SDNT8810/Timiac/Simulator/close.jpeg

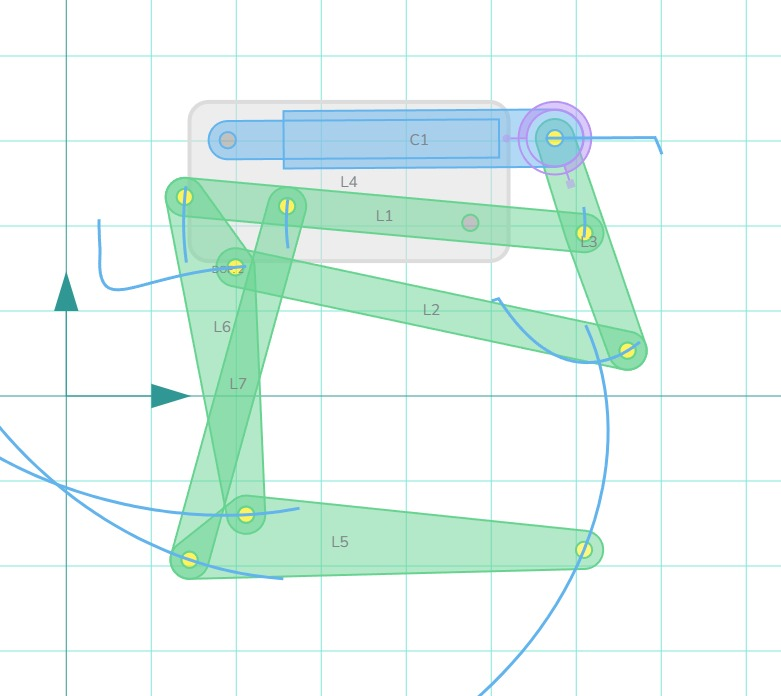
Simulator/close.jpeg
