SDNT8810/Timiac/Docs/remote-updates.md

# Remote updates for all five boards — 2026-10-15.6

**Local hotspot updates are also supported from 2026-10-19.2.** Cloud and USB
remain available. See [local hotspot, cloud and USB instructions](local-updates.md).

After one initial installation, update the master ESP32, both ESP-12 bridges,
and both Octopus boards through **https://control.timiac.it/**. Only the master
needs internet; it forwards the other images over the clock's own Wi-Fi.
No PC beside the clock or extra control wires are needed for routine updates.

This package changes the homing configuration and identity to
**TIMIAC2-f09aa035bf26**. Install all five boards locally with this matched package;
the OTA service deliberately rejects changes to the hardware identity.

## Initial installation in Italy — once

Follow [instruction.md](../instruction.md) using this complete package:

1. Turn the system off. Update both Octopus cards with
   `python run.py octopus_release --sd I:\` (use each card's actual drive).
   Boot each board, confirm `firmware.bin` became `FIRMWARE.CUR`, then turn it off.
   **Reinsert the cards and leave them installed.** Use writable FAT32 cards.
2. Flash each ESP-12 separately through its 3.3 V programming adapter:
   `python run.py esp1_release --port COM5`, then
   `python run.py esp2_release --port COM5` (use the actual COM ports).
3. Flash the master with `python run.py master_release --port COM10`.
4. Reconnect the usual UART/power wires. Start the complete clock and connect
   the master to its internet router. Check both boards, the RTC and hand input.
5. Sign in at **https://control.timiac.it/**. Firmware updates should report ready.
   Perform the first remote update while someone is still beside the clock,
   and confirm Calibrate arms (under Maintenance), Open, and Start clock work afterward.

The existing ESP and Octopus bootloaders are used. Initial ESP flashing includes
the normal ESP bootloader/layout; the new application enables its update receiver.
The Octopus factory 32 KB SD bootloader is preserved. It installs a verified image
from the card after an automatic reset. Do not replace the Octopus bootloader or
change its BOOT jumper for this procedure.
An older Octopus application must receive the initial SD update before remote
updates can work; a bootloader change alone does not add this receiver.

## Routine update from Canada

On your PC, pull a complete, verified firmware package and run:

```powershell
git pull
python remote_update.py --target all
```

Enter the same **Andrea** dashboard password when prompted. The command checks
the local package, signs in over HTTPS, updates the master application, both
bridges, both Octopus boards, then the local dashboard, and waits for each result.
It stops on an error and never automatically retries a failed flashing job.

For one component use `--target esp1`, `esp2`, `octopus1`, `octopus2`, or `master`.
`master` includes its matching dashboard; `dashboard` updates that filesystem alone.
No Cloudflare token or account credentials are needed to perform a normal update.

On the remote dashboard, open **Firmware updates > Update one component from
GitHub**, choose a target and press **Update selected component**. No `.bin`
file or PC build is required. The service pins the latest pushed main commit,
reuses its verified GitHub build when available, and uploads/installs only the
selected image. If that exact build is missing or invalid, it compiles first.
Progress survives closing the page. **Full update** remains the option that
installs all six components; it does not automatically skip unchanged boards.

The automatic component mapping is:

| Dashboard target | Prepared GitHub image |
|---|---|
| Master ESP32 — application | `esp_master_release.bin` |
| Master ESP32 — local dashboard | `master_release_littlefs.bin` |
| ESP-12 bridge 1 | `esp_board1.bin` |
| ESP-12 bridge 2 | `esp_board2.bin` |
| Octopus 1 or Octopus 2 | `firmware.bin` (same image for both) |

Wait for **complete** before the next update. Keep power connected. Updates pause
the clock, cancel queued motion, and wait for the connected bridges to acknowledge
Stop. The clock remains parked across an update reboot. When finished, select
**Maintenance > Calibrate arms**, then **Show time / Start clock**. Starting the clock restores the normal
automatic startup behavior for subsequent power cycles.

Keep the mechanism clear and secure any load that relies on motor holding torque:
an Octopus reset temporarily disables its motor outputs.

## Verification and recovery

The cloud accepts only authenticated administrator uploads and checks file size,
board role, revision and image headers. Files are immutable and SHA-256 identified.
Downloads require the clock's device key over verified HTTPS. Bridge updates use
a per-boot challenge and HMAC-SHA256 covering the target, size, hash and job metadata.
Authorization headers carry an HMAC rather than a plaintext key. Paired firmware
images contain the existing shared device key; the local transfer uses the clock's
WPA2 Wi-Fi. This is not an independent public-key firmware-signing system.

Both the master and receiving bridge check SHA-256 before activation. Octopus
images are first staged on their bridge, then transferred in numbered, CRC-checked
blocks to `timiac.upd` on the microSD. Marlin checks the entire file and its SD
readback before renaming it to `firmware.bin` and resetting into the factory loader.
An incomplete upload stays under a non-boot filename. Command retries do not write
the same block twice. A later attempt first clears any abandoned staging session.

Only one update or motion command may be queued. Update requests expire if not
started promptly and belong to one master boot session. A delivered job is not
replayed after a disconnect. **Stop** cancels transfer/staging before activation;
once flash activation or the bootloader copy has started, let it finish.

Routine OTA preserves the partition table, bootloaders and saved router settings.
The master filesystem is a separate update; stopping it or losing power can damage those
local web files, but the cloud updater can replace them again if the app still runs.
ESP32 application slots retain the previous image during download. The stock ESP
bootloaders do not provide a tested automatic health rollback for a bad application.
USB/SD recovery can still be required after power loss during flash copying or if
an installed application fails to boot or connect to Wi-Fi. A Marlin fatal halt
still requires resetting that Octopus before it can process an update.

This update supports firmware for the existing machine identity and flash layout.
A package that changes the mechanical/hardware identity is rejected; install such
a matched hardware migration locally. Firmware bootloaders themselves are not
replaced remotely.

Bridge maintenance addresses are `192.168.4.241:3232` and `192.168.4.242:3232`,
outside the normal AP DHCP lease range. They have no direct internet service.
The existing tracked clock pairing key is also used for update authentication;
repository access therefore includes access to that pairing material.

All boards compile and automated transfer/authentication/failure tests are run.
An end-to-end update on the physical clock has not been performed here.

## Gateway maintenance

For this initial cloud deployment, apply the additional tables before publishing:

```powershell
cd CloudGateway
npx wrangler d1 execute timiac-control --remote --file cloudflare/schema.sql
npm run check
npm test
npm run deploy
```

Firmware is stored in 64 KiB chunks in the existing D1 database; no new cloud
service or billing account is required. The existing login protects upload and
installation endpoints. Unused artifacts and finished receipts older than a week
are pruned on upload. See [CloudGateway/README.md](../CloudGateway/README.md).

References: [ESP32 OTA partitions](https://docs.espressif.com/projects/esp-idf/en/stable/esp32/api-reference/system/ota.html),
[ESP8266 updater](https://arduino-esp8266.readthedocs.io/en/3.1.1/ota_updates/readme.html),
[BTT Octopus SD bootloader](https://github.com/bigtreetech/docs/blob/master/docs/Octopus.md),
[Cloudflare D1 limits](https://developers.cloudflare.com/d1/platform/limits/).

## Full update: one button

Open the remote dashboard, sign in, and press **Full update** under Firmware updates. No firmware files need to be selected.

1. The server identifies the latest pushed commit on main and requests its verified firmware bundle.
2. GitHub prepares the bundle automatically after each push. Full update reuses the bundle for that exact commit when available; otherwise it builds it. Every component is checked before any board is updated.
3. The server installs the complete package in sequence, waiting for each board's verified success and reboot before continuing. Progress survives closing the browser.
4. If any build or installation fails, the sequence stops. Check the message/build log before trying again. Keep power connected throughout installation. **Stop** cancels the remaining sequence; a flash already activating must finish safely.
5. After success, calibrate/home the arms and resume operation from the dashboard.

Timiac installs the master ESP32 application first, then ESP bridge 1, ESP bridge 2,
Octopus 1, Octopus 2 and finally the local dashboard (six steps across five boards).
The displayed step number identifies the current step, not how many components
have succeeded. A failure at step 4 (Octopus 1) leaves steps 5 and 6 unattempted.
The master receives updater fixes before forwarding the other images. See
[USB recovery and persistent diagnostic logs](ota-recovery.md) if the old master
is offline or cannot finish its own update.

For one component, use **Update one component from GitHub** instead. That
request uploads one image and creates a single `1/1` installation step. Selecting
the master application updates only that application; select **Master ESP32 —
local dashboard** separately if its web files also changed. Bridges and Octopus
boards are not flashed as part of a master-only selection. All six supported
target/image pairs remain available.

From 2026-10-20.2, bridges persist the exact Octopus activation receipt before
requesting a reboot. A bridge restart during confirmation resumes checking the
running Octopus revision without requesting activation again. The master checks
the full receipt and the reported running revision before advancing. See
[Octopus SD update failures](sd-update-timeout.md) for the October 20 diagnosis.

### Faster build preparation — 2026-10-20

Pushing main starts a build-only preparation job; it does not contact, Stop or
update the clock. The prepared bundle is cached by the full source commit SHA.
Pressing Full update still resolves the current main commit and verifies every
image's SHA-256, role, revision and hardware identity before uploading it.
There is no fallback to firmware from a different commit. A missing, evicted or
invalid cache triggers a fresh build. Upload and sequential board installation
still take time even when compilation is skipped.

Builds for one commit queue together so an update can reuse an in-progress
preparation job. The workflow also caches pip/PlatformIO downloads, checks out
only shallow source history, and uses `python build.py cloud` to build the
release master, both ESP bridges and Octopus without the unused development
master. The complete verified bundle is saved before upload, so an interrupted
upload can reuse it on the next attempt. Cache eviction or the first run of a
new commit still needs compilation; no fixed completion time is guaranteed.

For local build verification without replacing the shipped binaries:

```powershell
python build.py cloud --output-dir .local/cloud-build-validation
```

The normal `python build.py all` and individual dev/release targets remain
available. This workflow change applies to new runs; an already-running Full
update keeps the workflow with which it started.

The initial USB/SD setup is still required once. Leave all Octopus microSD cards inserted and connect the controller to Internet Wi-Fi. Push your code before using Full update: uncommitted changes on a PC are not included.

### Automatic-build setup (maintainers)

The gateway uses `GITHUB_REPOSITORY`, `GITHUB_REF`, and the Worker secrets `GITHUB_BUILD_TOKEN` (repository Actions write/content read) and `FIRMWARE_BUILD_KEY`. The matching repository Actions secret `FIRMWARE_BUILD_KEY` authenticates uploads only; browser accounts and device keys cannot publish builds. `.github/workflows/full-update.yml` must also exist on the repository default branch for workflow dispatch registration. Lumiac's source/build branch remains RF.

Before deploying single-component selection to an existing Timiac gateway,
apply `CloudGateway/cloudflare/component-update.sql` once. It adds the durable
selection columns without changing existing update records. Push the workflow
and publisher first; single-component dispatches use the new optional
`component_target` and `component_kind` inputs.

The workflow runs on GitHub-hosted runners; no local PC or VPS build agent is needed. Build failures are reported to the dashboard. GitHub Actions must be enabled and have available build minutes. The builder uploads the verified complete bundle; bootloaders and partition tables are excluded from OTA.

For a build-only smoke test, an authenticated administrator can POST `{"validateOnly":true}` to `/api/devices/DEVICE_ID/full-update`. This builds and verifies everything without creating hardware update jobs. Normal dashboard clicks always build and install.

### Using another PC

The firmware's paired cloud configuration is committed with the source. `CloudGateway/project-secrets.json` also contains the project device key, Firebase API key, and full-build upload key, as requested. A normal pull includes these files; no credential copy/paste is needed to flash firmware or use the existing Full update service.

To reapply the project secrets to the existing Cloudflare Worker after signing into Wrangler, run `npm run configure:secrets --prefix CloudGateway`. This preserves its separately configured GitHub build account token. Repository/account authorization itself uses your normal GitHub and Cloudflare sign-in.
