SDNT8810/Timiac/Simulator/clock.jpeg

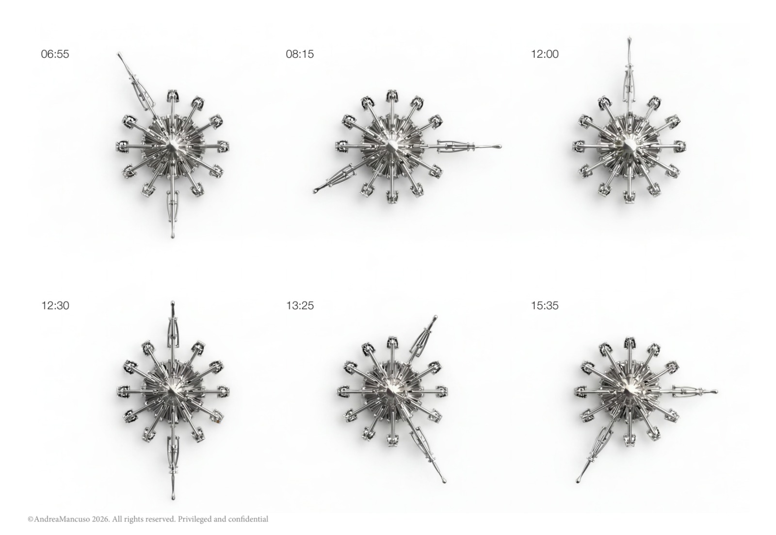
Simulator/clock.jpeg
