SDNT8810/Timiac/Simulator/mechanism.jpeg

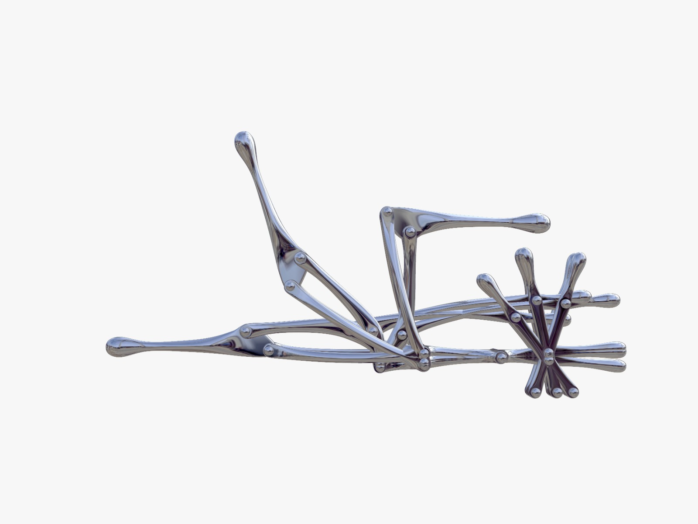
Simulator/mechanism.jpeg
