SDNT8810/Timiac/Simulator/open.jpeg

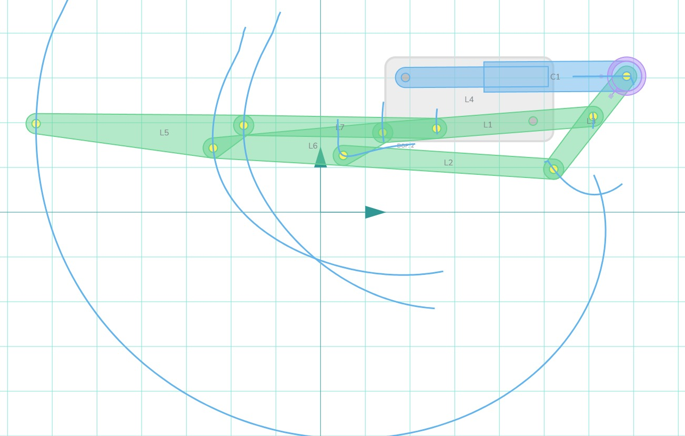
Simulator/open.jpeg
