SDNT8810/Timiac/Docs/wiring.md

# Twelve-motor wiring and commissioning

## Master ESP32-WROOM-32: RTC and new infrared hand sensor

Use the [complete master-board diagram and instructions](master-wiring.md):

Master ESP32 wiring

Keep the current **24 V to 3.3 V converter**, ESP32 and DS3231 connections.
For firmware **2026-10-20.3**, move only the installed low-voltage signal wire
from **GPIO27 to GPIO34 (ADC1)**. Keep the sensor power, common ground and all
installed resistors unchanged. The reported input is 95 mV clear and 2.5 mV
with a hand. The firmware uses analog presence detection rather than a digital
HIGH/LOW read. See the [sensor diagram](master-sensor-wiring.svg) and the
[low-voltage ADC limitations](master-wiring.md#analog-detection).
Never connect a raw 24 V sensor output directly to the ESP32. Keep the old
ultrasonic module unplugged and its GPIO18/19 traces unused.

| Module / signal | Master ESP32 connection |
|---|---|
| Converter 3.3 V output | 3V3 and DS3231 VCC |
| Converter / PSU / sensor ground | GND and DS3231 GND |
| DS3231 SDA | GPIO21 |
| DS3231 SCL | GPIO22 |
| Installed sensor resistor-divider junction | GPIO34, ADC1 analog input (no pull-up) |
| Existing ultrasonic GPIO18/19 | Unused |

These are GPIO labels, not development-board header positions. Leave RTC SQW
and 32K unconnected. The DS3231 and its I²C pull-ups remain at 3.3 V. The master
communicates with the motor bridges over Wi-Fi; it has no Octopus UART wiring.

Check both states' actual ADC readings as shown in [master-wiring.md](master-wiring.md). The dashboard reports
**Detected / Clear**, not centimetres. Clear for 500 ms, then present a hand for
200 ms to trigger one of seven random Struggle patterns once (valid RTC required).
Motion, Stop and faults discard hand
arrivals. A held hand cannot repeat until withdrawn. Manual release Home keeps
the arms parked; gestures require Start clock in release mode.

RTC diagnostics remain available at **http://192.168.4.1/api/rtc**. The bus uses
100 kHz, SDA GPIO21 and SCL GPIO22. `stage: address_probe` with `i2cCode: 2`
means address 0x68 did not acknowledge; code 5 means a timeout. A lost-power
message after successful communication requires setting the date/time.
See the [DS3231 manufacturer datasheet](https://www.analog.com/media/en/technical-documentation/data-sheets/ds3231.pdf).

## Per-axis commissioning baseline

Both boards use the identical six-axis image, adapted from Lumiac's working
configuration for TMC2209 UART and Timiac's mechanics. See
[lumiac-comparison.md](lumiac-comparison.md); confirm direction and calibration
on each physical mechanism before production use.

| Setting | Value |
|---|---|
| Board / MCU | BIGTREETECH Octopus V1.1 / STM32F446ZET6 |
| Motor / driver | X/Y/Z/A/B/C in G-code; Marlin internally calls the last three drivers I/J/K |
| Planned supply / chopper timing | 24 V / 400 W (16.7 A), CHOPPER_DEFAULT_24V |
| Current / microsteps | 1,000 mA RMS requested / 64 commanded, interpolated to 256 |
| Steps / travel | 11,520 steps/mm / 0–50 mm |
| Maximum feed | 8.333 mm/s = 500 mm/min |
| Acceleration | S-curve: 25 mm/s² travel, 80 mm/s² per-axis ceiling |
| Homing speed / direction | 120 mm/min, concurrent physical microswitch homing / toward each axis minimum |
| Stepper inactivity timeout | 600 seconds |
| Home input | Per-axis input in the table below, pull-up, normally closed switch to GND |
| Endstop inversion | false: released LOW, triggered HIGH |
| UART / USB | USART3 and USB, 115200 baud |
| Runtime SD / EEPROM settings | disabled |

The home endstop is at the **fully open** arm position: actuator **0 mm**.
Moving toward **50 mm closes** the arm. Keep the working motor directions and
minimum-endstop wiring; the master reverses visual clock/animation targets.
Both bridges and Octopus boards execute native actuator coordinates directly.

The active twelve-motor profile uses the reported actuator measurement on all
arms: 40 mm commanded produced 50 mm from home, so steps/mm becomes
`900 × 40 / 50 = 720` at four microsteps. At the selected 64 commanded microsteps,
the equivalent calibration is `720 × 64 / 4 = 11,520` steps/mm.
The driver interpolates internally to 256 microsteps. The 500 mm/min maximum
requires 96,000 step pulses/s; homing retains its 120 mm/min feed.
Home all uses Lumiac's independent per-motor switch stopping on both boards. Sensorless homing is removed in both modes.
Remove any MOTOR0–5 DIAG jumpers and reconnect NC switches with power off.
The generated image identifies itself
with the `TIMIAC2-` machine hash shared by all ESP images.

Flash the new `firmware.bin` to both Octopus boards, plus the updated master
and both bridge ESP images for the longer homing budgets. Home first, then
check a 10 mm move before rechecking 40 mm of actuator travel from zero.
These calculated settings still need a physical measurement after flashing.

M119 must show open when the switch is released and TRIGGERED when
actuated. Disconnecting an NC switch should also report TRIGGERED.
Verify each of the twelve switch inputs with stationary motors before running G28.
Install the driver's UART jumper; remove the DIAG jumper for a physical sensor.

### A/B/C homing troubleshooting

The latest profile restores `INVERT_I_DIR`, `INVERT_J_DIR`, and `INVERT_K_DIR`
to `false`, undoing the preceding direction reversal. This is a rollback,
not confirmation of the actual motor wiring or physical home direction.

The wiring counts the first endstop input as 1: X/Y/Z/A/B/C use the first six
inputs. A uses the 4th input (PG11 / STOP3), B the 5th (PG12 / STOP4), and
C the 6th (PG13 / STOP5). The previous PG12/PG13/PG14 mapping was one input
too high for this wiring. The current Lumiac layout uses MOTOR3/MOTOR4/MOTOR5 for A/B/C;
the motor output number does not select the endstop input.

For these physical switches, remove any DIAG3/DIAG4/DIAG5 jumpers connecting
driver diagnostic outputs to the three selected endstop inputs. Switch off
board power before changing jumpers. Keep the driver UART jumpers installed.

With all motors stationary, run M119 with each switch released and pressed.
Only the corresponding `a_min`, `b_min`, or `c_min` line should
change from `open` to `TRIGGERED`. If it does not change, check the connector,
signal/GND wiring, switch contact and DIAG jumper before attempting motion.

`echo:Bad A Endstop?` specifically means Marlin still reads the A home input
as triggered after the 5 mm homing backoff. The message confirms it recognized
axis A. This can happen if the switch is held, another arm's switch is connected
to the A input, the circuit is open, the driver/motor does not back off, or the
mechanism has not released the switch. The message alone does not distinguish
those causes. On Board 1 the A1 input is STOP3 / PG11 and its motor is now MOTOR3.

This error calls Marlin's `kill()` and requires the affected Octopus RESET
button or a power cycle. After reset, use the development switch lamps with
stationary motors: A1 should be red when released and green when pressed, and
only A1 should change. Do not hold the switch during an automatic homing
backoff. An NC switch or wire left disconnected reads triggered too.
The corrected bridge preserves this cause and shows **Reset required**;
Stop acknowledgements and later UART timeouts cannot erase it. Homing and
switch wiring still need physical verification after the fault is corrected.

Marlin's initial homing search is 1.5 times the configured 50 mm travel
(75 mm commanded). Do not wait for that search to finish if the motor moves
away from its sensor. `VALIDATE_HOMING_ENDSTOPS` stops on a missed switch;
`DETECT_BROKEN_ENDSTOP` now also stops if a switch remains triggered after
the 5 mm backoff. Neither check can establish that the physical direction
or wiring is correct.

## ESP32 master and two ESP-12S bridges

The master connects to power, the RTC and the hand sensor as shown above;
do not wire it to either Octopus serial port.
Each bridge connects only to its own Octopus:

| Bridge signal | Octopus signal |
|---|---|
| GPIO1 / TXD0 | PD9 / USART3 RX |
| GPIO3 / RXD0 | PD8 / USART3 TX |
| GND | GND |
| VCC | regulated 3.3 V |

Signal levels are 3.3 V. Do not put 5/12/24 V on an ESP or MCU signal pin.
A bare ESP needs adequate supply decoupling and Wi-Fi burst current,
EN/reset high, GPIO0/GPIO2 high, and GPIO15 low for normal boot.
Check the ESP-12S module's built-in resistors and actual Octopus socket
orientation. The pin table identifies electrical signals, not breakout dimensions.

All ESP builds assume 4 MB flash. Use UART at 115200, 8N1.
Remote firmware updates use the same wires, plus a FAT32 microSD card left in
each Octopus. See [the initial setup and remote update guide](remote-updates.md).
Do not connect two TX outputs together. Disconnect the Octopus UART when
flashing a bridge with a USB-UART adapter. Pull GPIO0 low during reset to
enter flashing mode, then release it for normal operation.

An optional physically rewired setup can set TIMIAC_SERIAL_SWAP = 1:
GPIO15/TX → PD9 and GPIO13/RX ← PD8. GPIO15 must remain low during reset.
This avoids ROM boot messages on the bridge's control TX but does not match
the default UART0 socket wiring.

## Flashing order

1. Use the same firmware/two-motor/firmware.bin on both FAT32 microSD cards.
   Boot each Octopus and confirm FIRMWARE.CUR. Bootloader SD flashing still
   works although runtime SD support and auto0.g execution are disabled.
   After confirming the flash, power off, remove the card, and power on again.
2. Flash timiac_master and its filesystem; flash timiac_board1 and
   timiac_board2 onto their respective bridges. Instructions are in [README](../README.md).
3. Connect the UART links and power all boards. Join Timiac / 12345678.
4. Open http://192.168.4.1, Take control, and inspect M115/M122/M119 logs.
   Both boards must report AXIS_COUNT:6 and answer normal Marlin status queries.
5. Home each local X/Y/Z/A/B/C axis separately, then test a 1 mm move on each motor.
6. Under supervision, verify Stop and interrupted-link behavior before larger
   programs. Stop uses M410 for ordinary movement and M112 during homing;
   interrupted homing requires an Octopus reset. Keep loads supported and
   a physical motor-power cutoff available.

After an ordinary Stop, wait for both bridges to reconnect, then Home again.
A board showing `Printer halted. kill() called!` needs its reset button or a
power cycle. Do not send USB motion or settings commands while
using the network controller.

## Active axis mapping

| Master Board 1 | Master Board 2 | Local Marlin | Motor socket | Endstop counted from 1 | Home input |
|---|---|---|---|---|---|
| X1 | X2 | X | MOTOR0 | 1st | STOP0 / X-STOP / PG6 |
| Y1 | Y2 | Y | MOTOR1 | 2nd | STOP1 / Y-STOP / PG9 |
| Z1 | Z2 | Z | MOTOR2_1 / DRIVER2 | 3rd | STOP2 / Z-STOP / PG10 |
| A1 | A2 | A | MOTOR3 / DRIVER3 | 4th | STOP3 / Z2-STOP / PG11 |
| B1 | B2 | B | MOTOR4 / DRIVER4 | 5th | STOP4 / E0-DET / PG12 |
| C1 | C2 | C | MOTOR5 / DRIVER5 | 6th | STOP5 / E1-DET / PG13 |

The active mapping now matches Lumiac: DRIVER0 through DRIVER5. Z uses the
MOTOR2 channel; MOTOR2_1 and MOTOR2_2 are parallel outputs of the same driver.
Use MOTOR2_1 for the single Z actuator and leave MOTOR2_2 empty. MOTOR6/7 are
unused. UART pins are PC4, PD11, PC6, PC7, PF2 and PE4 in X/Y/Z/A/B/C order.

To change from the preceding bypass layout, disconnect all board power and USB,
then move each driver and motor cable: Z 3→2, A 4→3, B 5→4, C 6→5. X/Y remain
on MOTOR0/1. The home switches do not move. Fit TMC2209 UART jumpers at all six
occupied slots; Lumiac uses a different SPI jumper arrangement. The user is
replacing both boards with new boards, so the old damaged channels no longer
determine this layout. Counting from DRIVER0, the third driver slot is DRIVER2
and serves both MOTOR2 connectors; the fourth slot is DRIVER3 and serves MOTOR3.

Pin references are in the vendored
Marlin/src/pins/stm32f4/pins_BTT_OCTOPUS_V1_common.h.
ESP serial behavior is documented in the
[ESP8266 core reference](https://arduino-esp8266.readthedocs.io/en/3.1.2/reference.html#serial).
