SDNT8810/Timiac/Docs/master-sensor-wiring.png

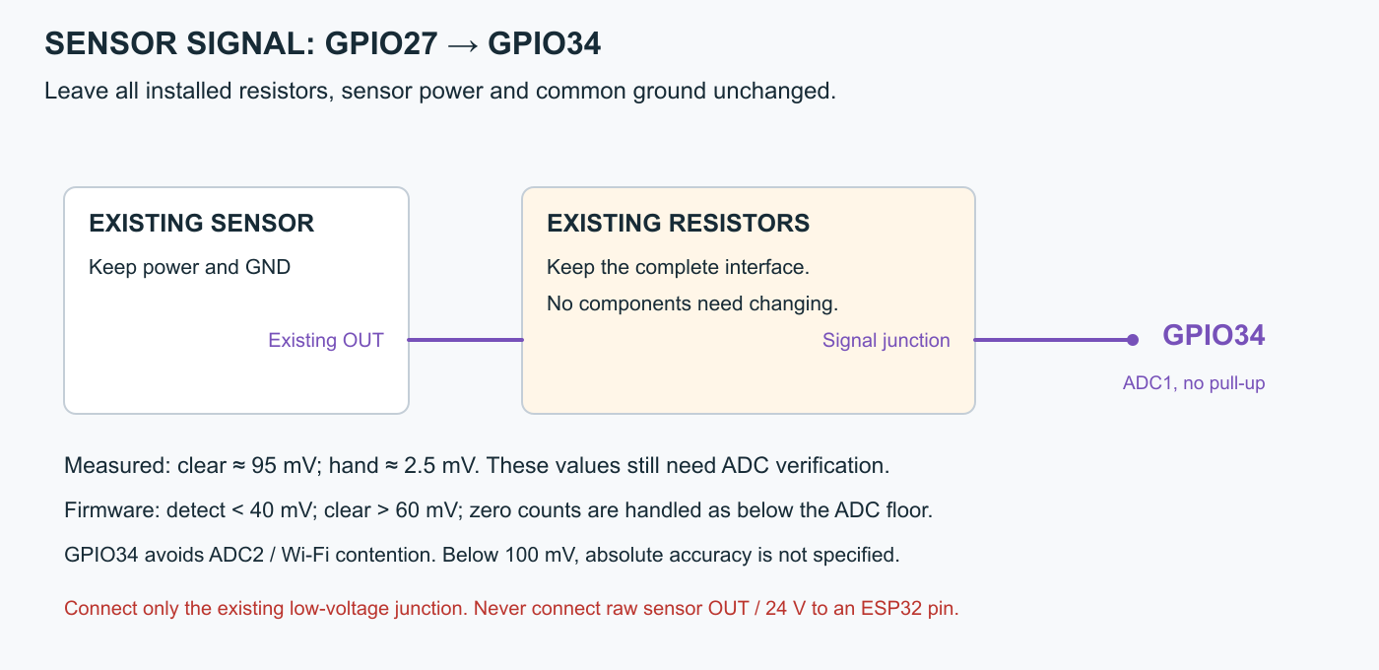
Docs/master-sensor-wiring.png
