SDNT8810/Timiac/Docs/master-wiring.png

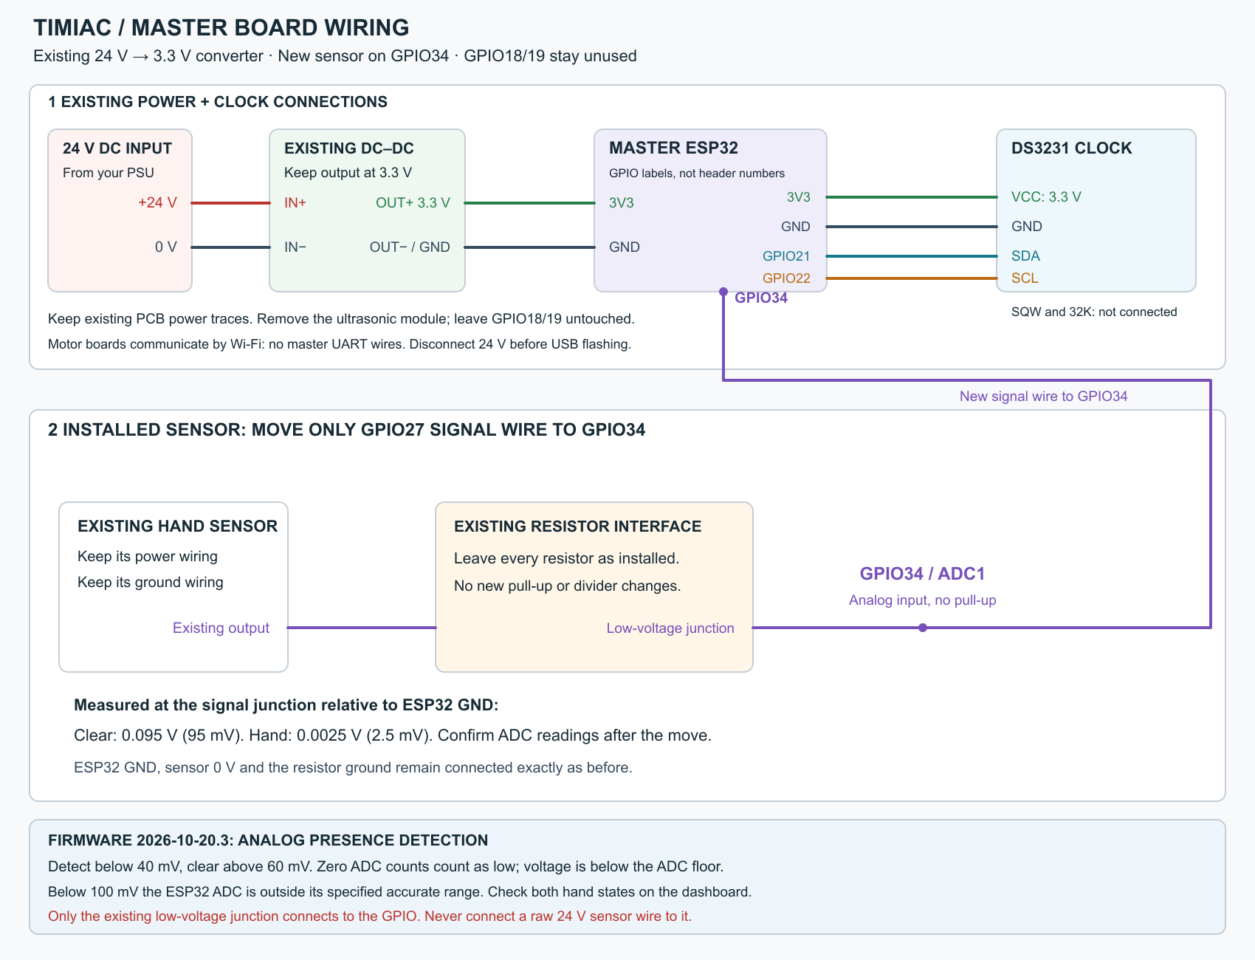
Docs/master-wiring.png
