SDNT8810/Timiac/Marlin/profiles/lumiac-reference/Configuration.h

#pragma once
#define CONFIG_EXAMPLES_DIR "linear_axes/Octopus 8 LINEAR_AXES"
#define CONFIGURATION_H_VERSION 02010206
#define STRING_CONFIG_H_AUTHOR "(OpenAI, Octopus v1.1 6-axis spider)" // Who made the changes.
#define SHOW_BOOTSCREEN
  #define MOTHERBOARD BOARD_BTT_OCTOPUS_V1_1
#define I_STEP_PIN    PG4   // MOTOR 3
#define I_DIR_PIN     PC1
#define I_ENABLE_PIN  PA0
#define I_CS_PIN      PC7
#define J_STEP_PIN    PF9   // MOTOR 4
#define J_DIR_PIN     PF10
#define J_ENABLE_PIN  PG2
#define J_CS_PIN      PF2
#define K_STEP_PIN    PC13  // MOTOR 5
#define K_DIR_PIN     PF0
#define K_ENABLE_PIN  PF1
#define K_CS_PIN      PE4
#define I_MIN_PIN     PG11  // Z2-STOP
#define J_MIN_PIN     PG12  // E0DET
#define K_MIN_PIN     PG13  // E1DET
#define U_MIN_PIN     PG14  // E2DET
#define V_MIN_PIN     PG15  // E3DET
#define SERIAL_PORT -1
#define BAUDRATE 250000
#define SERIAL_PORT_2 3
#define BAUDRATE_2 115200   // ESP bridge on Octopus WIFI header (PD8/PD9)
#define CUSTOM_MACHINE_NAME "Hexapod Spider"
#define X_DRIVER_TYPE  TMC5160
#define Y_DRIVER_TYPE  TMC5160
#define Z_DRIVER_TYPE  TMC5160
#define I_DRIVER_TYPE  TMC5160
#define J_DRIVER_TYPE  TMC5160
#define K_DRIVER_TYPE  TMC5160
  #define AXIS4_NAME 'A' // :['A', 'B', 'C', 'U', 'V', 'W']
  #define AXIS4_ROTATES
  #define AXIS5_NAME 'B' // :['B', 'C', 'U', 'V', 'W']
  #define AXIS5_ROTATES
  #define AXIS6_NAME 'C' // :['C', 'U', 'V', 'W']
  #define AXIS6_ROTATES
#define EXTRUDERS 0
#define DEFAULT_NOMINAL_FILAMENT_DIA 1.75
#define TEMP_SENSOR_0 0
#define TEMP_SENSOR_1 0
#define TEMP_SENSOR_2 0
#define TEMP_SENSOR_3 0
#define TEMP_SENSOR_4 0
#define TEMP_SENSOR_5 0
#define TEMP_SENSOR_6 0
#define TEMP_SENSOR_7 0
#define TEMP_SENSOR_BED 0
#define TEMP_SENSOR_PROBE 0
#define TEMP_SENSOR_CHAMBER 0
#define TEMP_SENSOR_COOLER 0
#define TEMP_SENSOR_BOARD 0
#define TEMP_SENSOR_REDUNDANT 0
#define DUMMY_THERMISTOR_998_VALUE  25
#define DUMMY_THERMISTOR_999_VALUE 100
#if TEMP_SENSOR_IS_MAX_TC(0)
  #define MAX31865_SENSOR_OHMS_0      100 // (Ω) Typically 100 or 1000 (PT100 or PT1000)
  #define MAX31865_CALIBRATION_OHMS_0 430 // (Ω) Typically 430 for Adafruit PT100; 4300 for Adafruit PT1000
#endif
#if TEMP_SENSOR_IS_MAX_TC(1)
  #define MAX31865_SENSOR_OHMS_1      100
  #define MAX31865_CALIBRATION_OHMS_1 430
#endif
#if TEMP_SENSOR_IS_MAX_TC(2)
  #define MAX31865_SENSOR_OHMS_2      100
  #define MAX31865_CALIBRATION_OHMS_2 430
#endif
#if HAS_E_TEMP_SENSOR
  #define TEMP_RESIDENCY_TIME         10  // (seconds) Time to wait for hotend to "settle" in M109
  #define TEMP_WINDOW                  1  // (°C) Temperature proximity for the "temperature reached" timer
  #define TEMP_HYSTERESIS              3  // (°C) Temperature proximity considered "close enough" to the target
#endif
#if TEMP_SENSOR_BED
  #define TEMP_BED_RESIDENCY_TIME     10  // (seconds) Time to wait for bed to "settle" in M190
  #define TEMP_BED_WINDOW              1  // (°C) Temperature proximity for the "temperature reached" timer
  #define TEMP_BED_HYSTERESIS          3  // (°C) Temperature proximity considered "close enough" to the target
#endif
#if TEMP_SENSOR_CHAMBER
  #define TEMP_CHAMBER_RESIDENCY_TIME 10  // (seconds) Time to wait for chamber to "settle" in M191
  #define TEMP_CHAMBER_WINDOW          1  // (°C) Temperature proximity for the "temperature reached" timer
  #define TEMP_CHAMBER_HYSTERESIS      3  // (°C) Temperature proximity considered "close enough" to the target
#endif
#if TEMP_SENSOR_REDUNDANT
  #define TEMP_SENSOR_REDUNDANT_SOURCE    E1  // The sensor that will provide the redundant reading.
  #define TEMP_SENSOR_REDUNDANT_TARGET    E0  // The sensor that we are providing a redundant reading for.
  #define TEMP_SENSOR_REDUNDANT_MAX_DIFF  10  // (°C) Temperature difference that will trigger a print abort.
#endif
#define HEATER_0_MINTEMP   5
#define HEATER_1_MINTEMP   5
#define HEATER_2_MINTEMP   5
#define HEATER_3_MINTEMP   5
#define HEATER_4_MINTEMP   5
#define HEATER_5_MINTEMP   5
#define HEATER_6_MINTEMP   5
#define HEATER_7_MINTEMP   5
#define BED_MINTEMP        5
#define CHAMBER_MINTEMP    5
#define HEATER_0_MAXTEMP 275
#define HEATER_1_MAXTEMP 275
#define HEATER_2_MAXTEMP 275
#define HEATER_3_MAXTEMP 275
#define HEATER_4_MAXTEMP 275
#define HEATER_5_MAXTEMP 275
#define HEATER_6_MAXTEMP 275
#define HEATER_7_MAXTEMP 275
#define BED_MAXTEMP      150
#define CHAMBER_MAXTEMP  60
#define HOTEND_OVERSHOOT 15   // (°C) Forbid temperatures over MAXTEMP - OVERSHOOT
#define BED_OVERSHOOT    10   // (°C) Forbid temperatures over MAXTEMP - OVERSHOOT
#define COOLER_OVERSHOOT  2   // (°C) Forbid temperatures closer than OVERSHOOT
#define PIDTEMP           // See the PID Tuning Guide at https://reprap.org/wiki/PID_Tuning
#define PID_MAX  255      // Limit hotend current while PID is active (see PID_FUNCTIONAL_RANGE below); 255=full current
#define PID_K1     0.95   // Smoothing factor within any PID loop
    #define DEFAULT_KP  22.20
    #define DEFAULT_KI   1.08
    #define DEFAULT_KD 114.00
#define MAX_BED_POWER 255 // limits duty cycle to bed; 255=full current
#define MAX_CHAMBER_POWER 255 // limits duty cycle to chamber heater; 255=full current
  #define PID_FUNCTIONAL_RANGE 10 // If the temperature difference between the target temperature and the actual temperature
#define PREVENT_COLD_EXTRUSION
#define EXTRUDE_MINTEMP 170
#define PREVENT_LENGTHY_EXTRUDE
#define EXTRUDE_MAXLENGTH 200
#define THERMAL_PROTECTION_HOTENDS // Enable thermal protection for all extruders
#define THERMAL_PROTECTION_BED     // Enable thermal protection for the heated bed
#define THERMAL_PROTECTION_CHAMBER // Enable thermal protection for the heated chamber
#define THERMAL_PROTECTION_COOLER  // Enable thermal protection for the laser cooling
#define USE_XMIN_PLUG
#define USE_YMIN_PLUG
#define USE_ZMIN_PLUG
#define USE_IMIN_PLUG
#define USE_JMIN_PLUG
#define USE_KMIN_PLUG
#define USE_UMIN_PLUG
#define USE_VMIN_PLUG
#define ENDSTOPPULLUPS
#define X_MIN_ENDSTOP_INVERTING true  // Set to true to invert the logic of the endstop.
#define Y_MIN_ENDSTOP_INVERTING true  // Set to true to invert the logic of the endstop.
#define Z_MIN_ENDSTOP_INVERTING true  // Set to true to invert the logic of the endstop.
#define I_MIN_ENDSTOP_INVERTING true  // Set to true to invert the logic of the endstop.
#define J_MIN_ENDSTOP_INVERTING true  // Set to true to invert the logic of the endstop.
#define K_MIN_ENDSTOP_INVERTING true  // Set to true to invert the logic of the endstop.
#define U_MIN_ENDSTOP_INVERTING false // Set to true to invert the logic of the endstop.
#define V_MIN_ENDSTOP_INVERTING false // Set to true to invert the logic of the endstop.
#define W_MIN_ENDSTOP_INVERTING false // Set to true to invert the logic of the endstop.
#define X_MAX_ENDSTOP_INVERTING false // Set to true to invert the logic of the endstop.
#define Y_MAX_ENDSTOP_INVERTING false // Set to true to invert the logic of the endstop.
#define Z_MAX_ENDSTOP_INVERTING false // Set to true to invert the logic of the endstop.
#define I_MAX_ENDSTOP_INVERTING false // Set to true to invert the logic of the endstop.
#define J_MAX_ENDSTOP_INVERTING false // Set to true to invert the logic of the endstop.
#define K_MAX_ENDSTOP_INVERTING false // Set to true to invert the logic of the endstop.
#define U_MAX_ENDSTOP_INVERTING false // Set to true to invert the logic of the endstop.
#define V_MAX_ENDSTOP_INVERTING false // Set to true to invert the logic of the endstop.
#define W_MAX_ENDSTOP_INVERTING false // Set to true to invert the logic of the endstop.
#define Z_MIN_PROBE_ENDSTOP_INVERTING false // Set to true to invert the logic of the probe.
#define ENDSTOP_INTERRUPTS_FEATURE
  #define SPIDER_MICROSTEPS 16
#if SPIDER_MICROSTEPS != 2 && SPIDER_MICROSTEPS != 8 && SPIDER_MICROSTEPS != 16 && SPIDER_MICROSTEPS != 32 && SPIDER_MICROSTEPS != 64
  #error "SPIDER_MICROSTEPS must be 2, 8, 16, 32, or 64."
#endif
#define SPIDER_AXIS_STEPS_PER_UNIT (533.33f * SPIDER_MICROSTEPS / 16.0f)
#define DEFAULT_AXIS_STEPS_PER_UNIT { SPIDER_AXIS_STEPS_PER_UNIT, SPIDER_AXIS_STEPS_PER_UNIT, SPIDER_AXIS_STEPS_PER_UNIT, SPIDER_AXIS_STEPS_PER_UNIT, SPIDER_AXIS_STEPS_PER_UNIT, SPIDER_AXIS_STEPS_PER_UNIT }
#define DEFAULT_MAX_FEEDRATE          { 260, 260, 260, 260, 260, 260 } // 30% faster on all six arms
#define DEFAULT_MAX_ACCELERATION      { 80, 80, 80, 80, 80, 80 }
#define DEFAULT_ACCELERATION          25      // X, Y, Z and E acceleration for printing moves
#define DEFAULT_RETRACT_ACCELERATION  25      // E acceleration for retracts
#define DEFAULT_TRAVEL_ACCELERATION   25      // X, Y, Z acceleration for travel (non printing) moves
#define DEFAULT_EJERK    5.0  // May be used by Linear Advance
  #define JUNCTION_DEVIATION_MM 0.003 // (mm) Distance from real junction edge
  #define JD_HANDLE_SMALL_SEGMENTS    // Use curvature estimation instead of just the junction angle
#define S_CURVE_ACCELERATION
#define Z_MIN_PROBE_USES_Z_MIN_ENDSTOP_PIN
#define NOZZLE_TO_PROBE_OFFSET { 10, 10, 0 }
#define PROBING_MARGIN 10
#define XY_PROBE_FEEDRATE (133*60)
#define Z_PROBE_FEEDRATE_FAST (4*60)
#define Z_PROBE_FEEDRATE_SLOW (Z_PROBE_FEEDRATE_FAST / 2)
#define Z_CLEARANCE_DEPLOY_PROBE   10 // (mm) Z Clearance for Deploy/Stow
#define Z_CLEARANCE_BETWEEN_PROBES  5 // (mm) Z Clearance between probe points
#define Z_CLEARANCE_MULTI_PROBE     5 // (mm) Z Clearance between multiple probes
#define Z_PROBE_LOW_POINT          -2 // (mm) Farthest distance below the trigger-point to go before stopping
#define Z_PROBE_OFFSET_RANGE_MIN -20
#define Z_PROBE_OFFSET_RANGE_MAX 20
#define X_ENABLE_ON 0
#define Y_ENABLE_ON 0
#define Z_ENABLE_ON 0
#define E_ENABLE_ON 0 // For all extruders
#define I_ENABLE_ON 0
#define J_ENABLE_ON 0
#define K_ENABLE_ON 0
#define U_ENABLE_ON 0
#define V_ENABLE_ON 0
#define DISABLE_OTHER_EXTRUDERS   // Keep only the active extruder enabled
#define INVERT_X_DIR false
#define INVERT_Y_DIR false
#define INVERT_Z_DIR false
#define INVERT_I_DIR false
#define INVERT_J_DIR false
#define INVERT_K_DIR false
#define INVERT_U_DIR false
#define INVERT_V_DIR false
#define INVERT_E0_DIR false
#define INVERT_E1_DIR false
#define INVERT_E2_DIR false
#define INVERT_E3_DIR false
#define INVERT_E4_DIR false
#define INVERT_E5_DIR false
#define INVERT_E6_DIR false
#define INVERT_E7_DIR false
#define Z_HOMING_HEIGHT  0      // Don't raise Z before lateral homing moves.
#define X_HOME_DIR -1
#define Y_HOME_DIR -1
#define Z_HOME_DIR -1
#define I_HOME_DIR -1
#define J_HOME_DIR -1
#define K_HOME_DIR -1
#define U_HOME_DIR -1
#define V_HOME_DIR -1
#define X_BED_SIZE 120
#define Y_BED_SIZE 120
#define X_MIN_POS 0
#define Y_MIN_POS 0
#define Z_MIN_POS 0
#define X_MAX_POS X_BED_SIZE
#define Y_MAX_POS Y_BED_SIZE
#define Z_MAX_POS 120
#define I_MIN_POS 0
#define I_MAX_POS 120
#define J_MIN_POS 0
#define J_MAX_POS 120
#define K_MIN_POS 0
#define K_MAX_POS 120
#define MIN_SOFTWARE_ENDSTOPS
  #define MIN_SOFTWARE_ENDSTOP_X
  #define MIN_SOFTWARE_ENDSTOP_Y
  #define MIN_SOFTWARE_ENDSTOP_Z
  #define MIN_SOFTWARE_ENDSTOP_I
  #define MIN_SOFTWARE_ENDSTOP_J
  #define MIN_SOFTWARE_ENDSTOP_K
  #define MIN_SOFTWARE_ENDSTOP_U
  #define MIN_SOFTWARE_ENDSTOP_V
  #define MIN_SOFTWARE_ENDSTOP_W
#define MAX_SOFTWARE_ENDSTOPS
  #define MAX_SOFTWARE_ENDSTOP_X
  #define MAX_SOFTWARE_ENDSTOP_Y
  #define MAX_SOFTWARE_ENDSTOP_Z
  #define MAX_SOFTWARE_ENDSTOP_I
  #define MAX_SOFTWARE_ENDSTOP_J
  #define MAX_SOFTWARE_ENDSTOP_K
  #define MAX_SOFTWARE_ENDSTOP_U
  #define MAX_SOFTWARE_ENDSTOP_V
  #define MAX_SOFTWARE_ENDSTOP_W
#define HOMING_FEEDRATE_MM_M { 400, 400, 400, 400, 400, 400 }
#define VALIDATE_HOMING_ENDSTOPS
#define EEPROM_CHITCHAT       // Give feedback on EEPROM commands. Disable to save flash.
#define EEPROM_BOOT_SILENT    // Keep M503 quiet and only give errors during first load
#define HOST_KEEPALIVE_FEATURE        // Disable this if your host doesn't like keepalive messages
#define DEFAULT_KEEPALIVE_INTERVAL 2  // Number of seconds between "busy" messages. Set with M113.
#define BUSY_WHILE_HEATING            // Some hosts require "busy" messages even during heating
#define PREHEAT_1_LABEL       "PLA"
#define PREHEAT_1_TEMP_HOTEND 180
#define PREHEAT_1_TEMP_BED     70
#define PREHEAT_1_TEMP_CHAMBER 35
#define PREHEAT_1_FAN_SPEED     0 // Value from 0 to 255
#define PREHEAT_2_LABEL       "ABS"
#define PREHEAT_2_TEMP_HOTEND 240
#define PREHEAT_2_TEMP_BED    110
#define PREHEAT_2_TEMP_CHAMBER 35
#define PREHEAT_2_FAN_SPEED     0 // Value from 0 to 255
#define PRINTJOB_TIMER_AUTOSTART
#define LCD_LANGUAGE en
#define DISPLAY_CHARSET_HD44780 JAPANESE
#define LCD_INFO_SCREEN_STYLE 0
#define SDSUPPORT
#define SOFT_PWM_SCALE 0
#define SERVO_DELAY { 300 }
