SDNT8810/Timiac/Marlin/profiles/lumiac-reference/Configuration_adv.h

#define E0_AUTO_FAN_PIN -1
#define E1_AUTO_FAN_PIN -1
#define E2_AUTO_FAN_PIN -1
#define E3_AUTO_FAN_PIN -1
#define E4_AUTO_FAN_PIN -1
#define E5_AUTO_FAN_PIN -1
#define E6_AUTO_FAN_PIN -1
#define E7_AUTO_FAN_PIN -1
#define CHAMBER_AUTO_FAN_PIN -1
#define COOLER_AUTO_FAN_PIN -1
#define HOMING_BUMP_MM      { 2, 2, 2, 2, 2, 2 }             // (linear=mm, rotational=°) Backoff from endstops after first bump
#define HOMING_BUMP_DIVISOR { 2, 2, 2, 2, 2, 2 }             // Re-Bump Speed Divisor (Divides the Homing Feedrate)
#define MICROSTEP_MODES { 16, 16, 16, 16, 16, 16 } // [1,2,4,8,16]
    #define SPIDER_RUN_CURRENT_MA 2500
    #define SPIDER_HOME_CURRENT_MA 2500
    #define X_CURRENT      SPIDER_RUN_CURRENT_MA  // (mA RMS) Requires active cooling.
    #define X_CURRENT_HOME SPIDER_HOME_CURRENT_MA
    #define X_MICROSTEPS     SPIDER_MICROSTEPS // Keep in sync with steps/mm in Configuration.h
    #define Y_CURRENT      SPIDER_RUN_CURRENT_MA
    #define Y_CURRENT_HOME SPIDER_HOME_CURRENT_MA
    #define Y_MICROSTEPS     SPIDER_MICROSTEPS
    #define Z_CURRENT      SPIDER_RUN_CURRENT_MA
    #define Z_CURRENT_HOME SPIDER_HOME_CURRENT_MA
    #define Z_MICROSTEPS     SPIDER_MICROSTEPS
    #define I_CURRENT     SPIDER_RUN_CURRENT_MA
    #define I_CURRENT_HOME SPIDER_HOME_CURRENT_MA
    #define I_MICROSTEPS    SPIDER_MICROSTEPS
    #define J_CURRENT     SPIDER_RUN_CURRENT_MA
    #define J_CURRENT_HOME SPIDER_HOME_CURRENT_MA
    #define J_MICROSTEPS    SPIDER_MICROSTEPS
    #define K_CURRENT     SPIDER_RUN_CURRENT_MA
    #define K_CURRENT_HOME SPIDER_HOME_CURRENT_MA
    #define K_MICROSTEPS    SPIDER_MICROSTEPS
    #define CURRENT_STEP_DOWN     50  // [mA]
    #define REPORT_CURRENT_CHANGE
  #define X_HYBRID_THRESHOLD     100  // [mm/s]
  #define X2_HYBRID_THRESHOLD    100
  #define Y_HYBRID_THRESHOLD     100
  #define Y2_HYBRID_THRESHOLD    100
  #define Z_HYBRID_THRESHOLD       3
  #define Z2_HYBRID_THRESHOLD      3
  #define Z3_HYBRID_THRESHOLD      3
  #define Z4_HYBRID_THRESHOLD      3
  #define I_HYBRID_THRESHOLD       3  // [linear=mm/s, rotational=°/s]
  #define J_HYBRID_THRESHOLD       3  // [linear=mm/s, rotational=°/s]
  #define K_HYBRID_THRESHOLD       3  // [linear=mm/s, rotational=°/s]
  #define U_HYBRID_THRESHOLD       3  // [mm/s]
  #define V_HYBRID_THRESHOLD       3
  #define W_HYBRID_THRESHOLD       3
  #define E0_HYBRID_THRESHOLD     30
  #define E1_HYBRID_THRESHOLD     30
  #define E2_HYBRID_THRESHOLD     30
  #define E3_HYBRID_THRESHOLD     30
  #define E4_HYBRID_THRESHOLD     30
  #define E5_HYBRID_THRESHOLD     30
  #define E6_HYBRID_THRESHOLD     30
  #define E7_HYBRID_THRESHOLD     30
  #define SPIDER_SD_HOME_FILE "/gcodes/home.txt"
