SDNT8810/Timiac/firmware/two-motor/machine.json

{
  "identity": "TIMIAC2-f09aa035bf26",
  "generation": 2,
  "protocol": 7,
  "motion_speed_override": "M220-including-homing",
  "marlin_environment": "STM32F446ZE_btt",
  "marlin_configuration_base": "lumiac-b250656",
  "motherboard": "BOARD_BTT_OCTOPUS_V1_1",
  "travel_mm": 50,
  "full_steps_per_mm": 180,
  "max_feed_mm_min": 500,
  "homing_feed_mm_min": 240,
  "homing_mode": "microswitch",
  "homing_strategy": "concurrent-all",
  "acceleration_mm_s2": 25,
  "max_acceleration_mm_s2": 80,
  "junction_deviation_mm": 0.3,
  "driver": "TMC2209",
  "current_ma": 1000,
  "microsteps": 64,
  "rsense": 0.11,
  "uart_address": 0,
  "driver_mode": "hybrid",
  "hybrid_threshold_mm_s": 1,
  "hold_multiplier": 0.3,
  "chopper_timing": "CHOPPER_DEFAULT_24V",
  "axes": [
    {
      "name": "X",
      "marlin": "X",
      "socket": 0,
      "step": "PF13",
      "dir": "PF12",
      "enable": "PF14",
      "uart": "PC4",
      "endstop": "PG6"
    },
    {
      "name": "Y",
      "marlin": "Y",
      "socket": 1,
      "step": "PG0",
      "dir": "PG1",
      "enable": "PF15",
      "uart": "PD11",
      "endstop": "PG9"
    },
    {
      "name": "Z",
      "marlin": "Z",
      "socket": 2,
      "step": "PF11",
      "dir": "PG3",
      "enable": "PG5",
      "uart": "PC6",
      "endstop": "PG10"
    },
    {
      "name": "A",
      "marlin": "I",
      "socket": 3,
      "step": "PG4",
      "dir": "PC1",
      "enable": "PA0",
      "uart": "PC7",
      "endstop": "PG11"
    },
    {
      "name": "B",
      "marlin": "J",
      "socket": 4,
      "step": "PF9",
      "dir": "PF10",
      "enable": "PG2",
      "uart": "PF2",
      "endstop": "PG12"
    },
    {
      "name": "C",
      "marlin": "K",
      "socket": 5,
      "step": "PC13",
      "dir": "PF0",
      "enable": "PF1",
      "uart": "PE4",
      "endstop": "PG13"
    }
  ],
  "steps_per_mm": 11520
}
