SDNT8810/Timiac/shared/octopus_session.h

#pragma once
#include "gcode.h"
#include "endstops.h"
#include "driver_report.h"
#include "timeouts.h"

namespace timiac {
// Deterministic controller kernel. No Arduino, Wi-Fi, allocation, or global
// state. One outstanding UART command; completion is bound to that command.
class OctopusSession {
 public:
  enum class State { Offline, Identify, Drivers, Ready, Prepare, Prepared, Run, Drain, Halted };
  State state = State::Offline;
  DriverReport drivers;
  EndstopReport endstops;
  uint8_t homed = 0;
  float positions[6] = {};
  bool known[6] = {};
  char fault[180] = {}, active[128] = {};
  uint32_t failures = 0, completions = 0, resets = 0;
  bool waiting = false, identity = false;
  bool monitor = false;
  bool homingInFlight = false;
  bool driverReportAvailable = false;
  uint32_t diagnosticRecoveries = 0;
  uint32_t sent = 0, lastRx = 0, lastPoll = 0;
  unsigned speedPercent = 100;
  uint32_t driverReportAge(uint32_t now) const { return uint32_t(now - driverAt); }
  bool online(uint32_t now) const {
    return identity && state != State::Halted && uint32_t(now - lastRx) < (running() ? acknowledgementTimeout(active, speedPercent) : 15000U);
  }
  bool healthy(uint32_t now) const { return online(now) && drivers.good() && !fault[0]; }
  bool running() const { return state == State::Run; }
  bool prepared() const { return state == State::Prepared && !waiting && drivers.good() && !fault[0]; }
  bool halted() const { return state == State::Halted; }
  bool busy() const { return running() || state == State::Prepare || state == State::Prepared || state == State::Drain; }
  void clearPosition() { homed = 0; for (auto& value : known) value = false; }
  // An interrupted idle read-only report is not evidence that a motor moved.
  // Fence its late acknowledgements, re-identify the board and obtain a full
  // fresh driver report before allowing motion. Never retry a movement.
  const char* retryDiagnostic(uint32_t now) {
    if (state != State::Ready || !waiting || !drivers.good() || fault[0] ||
        (strcmp(active, "M122") && strcmp(active, "M119")) || diagnosticRetries >= 2) return nullptr;
    ++diagnosticRetries; ++diagnosticRecoveries;
    return beginDrain(now, true);
  }
  bool stage(const char* const* lines, unsigned count, uint32_t now, bool trajectory = false, unsigned percent = 100) {
    if (!validSpeedPercent(percent)) return false;
    if (state != State::Ready || !healthy(now) || count > (trajectory ? maxTrajectoryCommands : 6U)) return false;
    if (trajectory && (!count || homed != (1U << axisCount) - 1)) return false;
    size = cursor = 0; requireDriverCheck = false;
    speedPercent = percent;
    add("G21"); add("G90");
    char speed[16]; snprintf(speed, sizeof(speed), "M220 S%u", speedPercent); add(speed);
    // Clock poses can leave one whole Octopus motionless for over ten minutes.
    // Marlin's printer idle timeout then disables its motors and invalidates
    // homing; diagnostics/no-op G1s do not refresh that timer. Hold the pose
    // until an explicit release, including after manual Home. S0 changes
    // only the idle timeout: bare M18/M84 still releases motors normally.
    add("M84 S0");
    // Restore the normal travel acceleration even after an interrupted preset.
    char acceleration[24]; snprintf(acceleration, sizeof(acceleration), "M204 T%.3f", travelAcceleration); add(acceleration);
    for (unsigned n = 0; n < count; ++n) {
      if (!(trajectory ? validTrajectory(lines[n], axisCount, travelMm, maxFeed)
                       : validNative(lines[n], axisCount, travelMm, maxFeed))) { size = 0; return false; }
      if (!strncmp(lines[n], "G4 P", 4)) {
        // A stationary board uses dwell to match its partner's trajectory
        // frame. M220 only scales moves, so scale waits explicitly as well.
        char dwell[24];
        snprintf(dwell, sizeof(dwell), "G4 P%.0f", ceilf(strtof(lines[n] + 4, nullptr) * 100.0f / speedPercent));
        if (!add(dwell)) return false;
      } else if (homingCommand(lines[n])) {
        requireDriverCheck = true;
        // Preserve the group so Octopus can stop each arm independently in
        // one concurrent seek, just like Lumiac. Mark homed only on its ack.
        if (!add(lines[n])) return false;
      } else {
        if (!strncmp(lines[n], "G1 ", 3) && (moveMask(lines[n]) & homed) != moveMask(lines[n])) { size = 0; return false; }
        if (!add(lines[n])) return false;
      }
    }
    if (!add("M400") || !add("M114")) return false;
    state = State::Prepare;
    return true;
  }
  bool commit() {
    if (!prepared()) return false;
    state = State::Run; endstops.clear(); return true;
  }
  // Returns the immediate command to transmit, or null. Homing is a blocking
  // Marlin routine: M410 alone does not cancel its subsequent bump/move calls.
  // A homing emergency therefore uses M112 and truthfully requires board reset.
  const char* stop(uint32_t now) {
    const bool homing = homingInFlight;
    size = cursor = 0; clearPosition(); endstops.clear();
    if (state == State::Halted) return nullptr;
    if (state == State::Drain) return nullptr;
    if (homing) {
      fail("Homing stopped. Reset this Octopus before continuing.", true);
      return "M112";
    }
    // Drain all old acknowledgements, including M118's own ok, before a fresh
    // handshake. A late reply to an earlier drain attempt cannot complete it.
    return beginDrain(now);
  }
  void fail(const char* message, bool hard = false) {
    // Only an actual board restart may release a confirmed halt.
    if (state == State::Halted) return;
    if (!fault[0]) snprintf(fault, sizeof(fault), "%s", message);
    // Retaining the first fault must not hide a later loss of communication.
    ++failures;
    size = cursor = 0; clearPosition(); endstops.clear(); waiting = false;
    state = hard ? State::Halted : State::Offline;
    if (hard) identity = false;
  }
  const char* next(uint32_t now) {
    if (state == State::Halted) return nullptr;
    if (state == State::Drain) {
      if (diagnosticDrainPending) { diagnosticDrainPending = false; return active; }
      if (uint32_t(now - sent) >= 10000) {
        if (diagnosticDrain) { fail("Read-only diagnostic recovery timed out; checking Octopus link"); return nullptr; }
        if (!fault[0]) {
          snprintf(fault, sizeof(fault), "Octopus link unavailable after Stop; retrying"); ++failures;
        }
        // Missing serial traffic is not evidence of a killed Marlin. Keep
        // motion blocked and retry only the stop/drain, never the lost job.
        return beginDrain(now);
      }
      return nullptr;
    }
    if (waiting) {
      const uint32_t limit = running() ? acknowledgementTimeout(active, speedPercent) : 10000;
      if (uint32_t(now - sent) >= limit) {
        if (const char* retry = retryDiagnostic(now)) return retry;
        char message[180];
        snprintf(message, sizeof(message), "%s acknowledgement timed out; checking Octopus link", active);
        fail(message);
      }
      return nullptr;
    }
    if (state == State::Offline) {
      if (now < 3000 || uint32_t(now - lastPoll) < 1000) return nullptr;
      state = State::Identify; identity = false; lastPoll = now;
      return transmit("M115", now);
    }
    if (state == State::Drivers) return transmit("M122", now);
    if (state == State::Prepare) {
      if (requireDriverCheck) { requireDriverCheck = false; return transmit("M122", now); }
      state = State::Prepared; return nullptr;
    }
    if (state == State::Run) {
      if (cursor < size) return transmit(queue[cursor++], now);
      state = State::Ready; ++completions; lastPoll = now; return nullptr;
    }
    if (state == State::Ready && uint32_t(now - lastPoll) >= (monitor ? 500U : 5000U)) {
      lastPoll = now;
      // Read-only checks continue independently on each board, even when the
      // other board is offline. Refresh passing reports too; never replay motion.
      if (uint32_t(now - driverAt) >= (monitor ? 2000U : 5000U)) return transmit("M122", now);
      return transmit("M119", now);
    }
    return nullptr;
  }
  void receive(const char* line, uint32_t now) {
    if (!strcmp(line, "start")) {
      const bool interrupted = busy();
      state = State::Offline; identity = waiting = false; drivers.begin(); clearPosition(); endstops.clear();
      driverReportAvailable = false;
      homingInFlight = false;
      diagnosticDrain = diagnosticDrainPending = false; diagnosticRetries = 0;
      fault[0] = 0; size = cursor = 0; lastPoll = now; ++resets;
      if (interrupted) { snprintf(fault, sizeof(fault), "Octopus restarted during work"); ++failures; }
      return;
    }
    if (strstr(line, "Printer halted") || strstr(line, "kill() called")) { fail(line, true); return; }
    if (!strncmp(line, "echo:Bad ", 9) && strstr(line, " Endstop?")) { fail(line, true); return; }
    if (state == State::Halted) return;
    if (!strcmp(line, "Six-arm homing cancelled.")) { fail(line); return; }
    if (state == State::Drain) {
      const char* marker = !strncmp(line, "echo:", 5) ? line + 5 : line;
      if (!strcmp(marker, drainMarker)) drainMarkerSeen = true;
      else if (drainMarkerSeen && (!strcmp(line, "ok") || !strncmp(line, "ok ", 3))) {
        state = State::Offline; waiting = false; lastPoll = now; fault[0] = 0;
      }
      return;
    }
    if (!strncmp(line, "Error:", 6) || !strncmp(line, "!!", 2) || !strncmp(line, "Resend:", 7) ||
        strstr(line, "Unknown command") || (strstr(line, "Home ") && strstr(line, " First"))) {
      fail(line); return;
    }
    if (!waiting) return;
    lastRx = now;
    if (!strcmp(active, "M115") && strstr(line, "FIRMWARE_NAME:")) {
      identity = fieldMatches(line, "MACHINE_TYPE:", machineId) && fieldMatches(line, "AXIS_COUNT:", "6");
    }
    if (!strcmp(active, "M122")) pendingDrivers.receive(line);
    if (!strcmp(active, "M119")) endstops.receive(line);
    if (!strcmp(active, "M114") || homingCommand(active)) readPosition(line);
    if (strcmp(line, "ok") && strncmp(line, "ok ", 3)) return;
    waiting = false;
    homingInFlight = false;
    if (state == State::Identify) {
      if (!identity) { fail("Wrong Octopus firmware: flash the matching TIMIAC2 image"); return; }
      state = State::Drivers;
    } else if (!strcmp(active, "M122")) {
      if (!pendingDrivers.complete() && state == State::Ready) {
        // Lost UART bytes must not turn an incomplete diagnostic into a
        // permanent unhomed condition. A complete failing report is a fault.
        waiting = true;
        if (retryDiagnostic(now)) { diagnosticDrainPending = true; return; }
        waiting = false; fail("Incomplete driver diagnostics after two recovery attempts"); return;
      }
      drivers = pendingDrivers;
      driverReportAvailable = true;
      driverAt = now;
      if (!drivers.good()) {
        snprintf(fault, sizeof(fault), "%s", drivers.thermalWarning || (drivers.thermalHistory && drivers.currentOk != 63)
          ? "Driver overheated/current reduced: cool drivers, then reset Octopus and Home"
          : "Driver check failed: connection/current/microsteps/mode; see driver panel");
        if (state == State::Prepare || state == State::Run) { ++failures; size = cursor = 0; clearPosition(); }
        state = State::Ready;
      } else {
        diagnosticRetries = 0;
        fault[0] = 0;
        if (state == State::Drivers) state = State::Ready;
      }
    } else if (!strcmp(active, "M119")) endstops.finish(now);
    if (running() && homingCommand(active)) {
      const uint8_t mask = moveMask(active);
      homed |= mask;
      for (unsigned a = 0; a < 6; ++a) if (mask & (1U << a)) { known[a] = true; positions[a] = 0; }
    }
    if (running() && (!strcmp(active, "M18") || !strcmp(active, "M84"))) clearPosition();
  }
  static uint8_t moveMask(const char* line) {
    uint8_t mask = 0;
    for (unsigned a = 0; a < 6; ++a) if (strchr(line, axes[a])) mask |= 1U << a;
    return mask;
  }
 private:
  char queue[44][128] = {};
  unsigned size = 0, cursor = 0;
  bool requireDriverCheck = false;
  uint32_t driverAt = 0;
  uint32_t drainSequence = 0;
  char drainMarker[40] = {};
  bool drainMarkerSeen = false;
  bool diagnosticDrain = false, diagnosticDrainPending = false;
  unsigned diagnosticRetries = 0;
  DriverReport pendingDrivers;
  const char* beginDrain(uint32_t now, bool diagnostic = false) {
    state = State::Drain; waiting = identity = false; sent = now;
    diagnosticDrain = diagnostic; diagnosticDrainPending = false;
    // M115 alone must not republish yesterday's passing masks as readiness
    // while the replacement M122 is still in flight after a diagnostic fault.
    if (diagnostic) { drivers.begin(); driverReportAvailable = false; }
    drainMarkerSeen = false;
    snprintf(drainMarker, sizeof(drainMarker), "TIMIAC_DRAINED_%lu", static_cast<unsigned long>(++drainSequence));
    snprintf(active, sizeof(active), diagnostic ? "M118 %s" : "M410\nM400\nM118 %s", drainMarker);
    return active;
  }
  static bool fieldMatches(const char* line, const char* key, const char* value) {
    const char* p = strstr(line, key);
    if (!p) return false;
    p += strlen(key); const size_t length = strlen(value);
    return !strncmp(p, value, length) && (!p[length] || p[length] == ' ');
  }
  bool add(const char* line) {
    if (size >= 44 || strlen(line) >= 128) { size = 0; return false; }
    strcpy(queue[size++], line); return true;
  }
  const char* transmit(const char* command, uint32_t now) {
    snprintf(active, sizeof(active), "%s", command); waiting = true; sent = now;
    homingInFlight = homingCommand(active);
    if (!strcmp(active, "M119")) endstops.begin();
    if (!strcmp(active, "M122")) pendingDrivers.begin();
    return active;
  }
  void readPosition(const char* line) {
    for (unsigned a = 0; a < 6; ++a) {
      char key[] = "X:"; key[0] = axes[a];
      const char* p = strstr(line, key);
      if (!p || (p != line && p[-1] != ' ')) continue;
      char* end = nullptr; const float value = strtof(p + 2, &end);
      if (end != p + 2 && isfinite(value)) { known[a] = true; positions[a] = value; }
    }
  }
};
}
