SDNT8810/Timiac/ESP_Timiac/src/runtime.h

#pragma once
struct LogEntry { uint32_t id = 0, at = 0; String text; };
constexpr uint32_t kLogCapacity = 16;
LogEntry logs[kLogCapacity];
uint32_t logSequence = 0, sequence = 0;
String bootId, coordinatorBoot, serialLine;
String bridgeResetReason;
#include "persistent_diagnostics.h"
uint32_t lastPeerRejection = 0;
bool serialDiscard = false, stopRequested = false, systemLatched = false, stopPending = false;
bool networkChanging = false;
bool firmwareUpdating = false, firmwareUpdateCancel = false;
bool cloudInFlight = false;
String systemFault, stopToken, stopReason, acknowledgedStop;
String lastStopReason, lastStopSession, clockPauseReason;
uint32_t lastStopAt = 0, lastStopCount = 0;
void rememberStop(const String& reason) {
  lastStopReason = reason; lastStopSession = bootId; lastStopAt = millis(); ++lastStopCount;
#if TIMIAC_MASTER && defined(ARDUINO_ARCH_ESP32)
  Preferences history;
  if (history.begin("timiac-history", false)) {
    DynamicJsonDocument saved(512);
    saved["reason"] = reason; saved["session"] = lastStopSession; saved["at"] = lastStopAt; saved["count"] = lastStopCount;
    String text; serializeJson(saved, text); history.putString("stop", text); history.end();
  }
#endif
}
void configureReliability() {
  configurePersistentDiagnostics();
#if TIMIAC_MASTER && defined(ARDUINO_ARCH_ESP32)
  Preferences history;
  if (history.begin("timiac-history", true)) {
    DynamicJsonDocument saved(512);
    if (!deserializeJson(saved, history.getString("stop", "{}"))) {
      lastStopReason = saved["reason"] | ""; lastStopSession = saved["session"] | "";
      lastStopAt = saved["at"] | 0U; lastStopCount = saved["count"] | 0U;
    }
    history.end();
  }
#endif
}
void writeReliabilityStatus(JsonObject status) {
  status["uptimeMs"] = millis(); status["lastStop"] = lastStopReason; status["stopCount"] = lastStopCount;
  status["lastStopSession"] = lastStopSession;
  if (lastStopSession == bootId && !lastStopReason.isEmpty()) status["lastStopAgeMs"] = uint32_t(millis() - lastStopAt);
  else status["lastStopAgeMs"] = nullptr;
  status["diagnosticWriteFailures"] = diagnosticWriteFailures;
  writeSavedUpdateCheckpoint(status.createNestedObject("lastUpdate"));
#if TIMIAC_MASTER && defined(ARDUINO_ARCH_ESP32)
  status["freeHeap"] = platformFreeNetworkHeap();
  status["minFreeHeap"] = heap_caps_get_minimum_free_size(MALLOC_CAP_INTERNAL | MALLOC_CAP_8BIT);
  status["largestFreeBlock"] = platformLargestNetworkBlock();
  status["resetReason"] = unsigned(esp_reset_reason());
  writeTlsMemoryStatus(status);
#endif
}
uint8_t stopRequired = 0, stopRecoveryRequired = 0;
uint32_t lastStateTx = 0, reconnectAt = 0, reconnectDelay = 500, lastWifiRetry = 0;

struct Peer {
  WiFiClient socket;
  String line, boot, closeReason;
  timiac::PeerOutbox outbox;
  int board = -1;
  bool paired = false, discard = false;
  uint32_t rx = 0, tx = 0;
} peers[TIMIAC_MASTER ? 2 : 1];
struct RemoteBoard {
  timiac::EndstopReport endstops;
  timiac::DriverReport drivers;
  String firmware;
  String diagnostic, software, octopusSoftware;
  uint32_t uptime = 0;
  bool driverReportAvailable = false;
  bool trajectorySupported = false;
  bool otaSupported = false, sdOtaSupported = false, updating = false;
  uint32_t driverReportAt = 0;
  bool online = false, busy = false, latched = false, resetRequired = false;
  uint8_t homed = 0;
  uint32_t reset = 0, stateAt = 0;
  String fault, stopAck;
  float positions[6] = {};
  bool known[6] = {};
} boards[2];
struct Operation {
  String id, error;
  uint32_t hash = 0;
  bool homing = false;
  unsigned speedPercent = 100;
  timiac::Barrier barrier;
} operation;
struct Receipt { String id, state, error; uint32_t hash = 0; };
Receipt receipts[16];
unsigned receiptNext = 0;
struct Lease {
  String owner, label;
  uint32_t fence = 0, renewed = 0, lastSeq = 0;
  bool live() const { return !owner.isEmpty() && !timiac::expired(millis(), renewed, kLeaseMs); }
} lease;
timiac::GcodeState manualParser;
unsigned motionSpeedPercent = timiac::defaultSpeedPercent;
int armTimeMinutes = -1;
int releaseClockMinute = -1; // Last automatic target; survives a proximity animation.
bool releaseClockEnabled = false;
bool releaseStartupPending = TIMIAC_MASTER && TIMIAC_RELEASE;
#if TIMIAC_MASTER
unsigned lastStruggleVariant = timiac::struggleVariantCount;
#endif
void trackManualClockAction(const char* action) {
#if TIMIAC_RELEASE
  releaseClockEnabled = !systemLatched && !strcmp(action, "show-time");
  clockPauseReason = releaseClockEnabled ? "" : String("Manual ") + action;
  releaseClockMinute = -1;
#if defined(ARDUINO_ARCH_ESP32)
  if (releaseClockEnabled) {
    Preferences settings;
    if (settings.begin("timiac-ota", false)) { settings.putBool("park", false); settings.end(); }
  }
#endif
#endif
}
struct Program {
  String id, name, state = "empty", error, uploadOwner, translation;
  unsigned total = 0, uploaded = 0, completed = 0;
  uint32_t bytes = 0, lastHash = 0, activity = 0;
  File file;
  timiac::GcodeState parser;
  bool hasStep = false;
  bool builtin = false;
  timiac::Preset preset = timiac::Preset::Struggle;
  unsigned struggleVariant = 0;
  unsigned targetMinute = 0;
  uint32_t actionHash = 0;
  bool reserved() const { return state == "uploading" || state == "running" || state == "paused"; }
} program;
void recordProgramReceipt() {
  if (!program.builtin) return;
  Receipt* target = nullptr;
  for (auto& r : receipts) if (r.id == program.id) { target = &r; break; }
  if (!target) { target = &receipts[receiptNext]; receiptNext = (receiptNext + 1) % 16; }
  target->id = program.id; target->hash = program.actionHash;
  target->state = program.state == "faulted" ? "failed" : program.state;
  target->error = program.error;
}
void logMessage(const String& message);
bool sendPeer(Peer& peer, JsonDocument& doc);
void sendState();
void stopAll(const String& reason);
bool bothOnline();
bool bothHealthy();
bool boardsHealthy(uint8_t mask);
void finishLocal();
void startOperation(JsonArray a, JsonArray b, const String& id, uint32_t hash, uint8_t mask = 3, bool trajectory = false);
void recordReceipt() {
  for (auto& r : receipts) if (r.id == operation.id) {
    r.state = operation.barrier.name(); r.error = operation.error; return;
  }
  Receipt& receipt = receipts[receiptNext];
  receipt.id = operation.id; receipt.state = operation.barrier.name();
  receipt.error = operation.error; receipt.hash = operation.hash;
  receiptNext = (receiptNext + 1) % 16;
}
uint32_t hashText(const String& text) {
  uint32_t hash = 2166136261UL;
  for (unsigned i = 0; i < text.length(); ++i) hash = (hash ^ uint8_t(text[i])) * 16777619UL;
  return hash;
}
uint32_t commandHash(JsonVariant a, JsonVariant b) {
  String text; serializeJson(a, text); text += '|'; serializeJson(b, text);
  return hashText(text);
}
bool validLines(JsonVariant value, bool trajectory = false) {
  if (!value.is<JsonArray>() || value.size() > (trajectory ? timiac::maxTrajectoryCommands : kMaxCommands)) return false;
  for (JsonVariant entry : value.as<JsonArray>())
    if (!entry.is<const char*>() || !(trajectory
        ? timiac::validTrajectory(entry.as<const char*>(), kAxisCount, kTravelMm, kMaxFeed)
        : timiac::validNative(entry.as<const char*>(), kAxisCount, kTravelMm, kMaxFeed))) return false;
  return true;
}
bool validStep(JsonVariant step) {
  return validLines(step["a"]) && validLines(step["b"]) && (step["a"].size() || step["b"].size());
}
bool hasMove(JsonArray lines) {
  for (JsonVariant value : lines) if (String(value.as<const char*>()).startsWith("G1 ")) return true;
  return false;
}
bool hasHoming(JsonArray lines) {
  for (JsonVariant value : lines) if (timiac::homingCommand(value.as<const char*>())) return true;
  return false;
}
bool homingReady(JsonVariant step) {
  for (unsigned b = 0; b < 2; ++b)
    for (JsonVariant line : step[b == 0 ? "a" : "b"].as<JsonArray>()) {
      const char* command = line.as<const char*>();
      if (!strncmp(command, "G1 ", 3))
        for (unsigned a = 0; a < 6; ++a)
          if (strchr(command, kAxes[a]) && !(boards[b].homed & (1U << a))) return false;
    }
  return true;
}
const char* translate(const char* line, timiac::GcodeState& state, JsonObject doc) {
  timiac::Step step;
  const char* error = timiac::compileLine(line, state, step, kAxisCount, kTravelMm, kMaxFeed);
  if (error) return error;
  for (unsigned b = 0; b < 2; ++b) {
    JsonArray lines = doc.createNestedArray(b == 0 ? "a" : "b");
    for (unsigned i = 0; i < step.count[b]; ++i) lines.add(step.lines[b][i]);
  }
  return nullptr;
}
