SDNT8810/Timiac/ESP_Timiac/src/cloud_transport.h

#pragma once
#include <freertos/queue.h>
#include <new>

// Only serialized messages cross the task boundary. The worker never touches
// motors, peers, the clock, OTA state, or the runtime mutex. DNS/TLS may block;
// the real-time coordinator must continue to service its 250 ms heartbeats.
struct CloudExchange {
  String payload, response, error;
  uint32_t elapsed = 0;
};
QueueHandle_t cloudRequests = nullptr, cloudResponses = nullptr;
TaskHandle_t cloudTask = nullptr;

void performCloudExchange(CloudExchange& exchange) {
  const uint32_t started = millis();
  WiFiClientSecure client;
  client.setCACert(strlen(TIMIAC_CLOUD_CA_CERT) ? TIMIAC_CLOUD_CA_CERT : kCloudRunRootCa);
  // This worker is isolated from motor control. Give certificate negotiation
  // enough time on the ESP32 instead of abandoning it after three seconds.
  client.setHandshakeTimeout(20);
  HTTPClient request;
  request.setConnectTimeout(8000); request.setTimeout(8000);
  // deserializeJson reads the stream directly; HTTP/1.0 avoids raw chunk framing.
  request.useHTTP10(true); request.setReuse(false);
  const String endpoint = String(TIMIAC_CLOUD_URL) + "/device/v1/devices/" + TIMIAC_CLOUD_DEVICE_ID + "/sync";
  if (!request.begin(client, endpoint)) { exchange.error = "Could not start secure cloud connection"; exchange.elapsed = millis() - started; return; }
  request.addHeader("Content-Type", "application/json");
  request.addHeader("X-Timiac-Device-Key", TIMIAC_CLOUD_DEVICE_KEY);
  // POST(String) takes its argument by value in this SDK. Avoid retaining a
  // second complete status string throughout the TLS handshake.
  const int code = request.POST(reinterpret_cast<uint8_t*>(const_cast<char*>(exchange.payload.c_str())), exchange.payload.length());
  exchange.payload = "";
  if (code < 0) {
    // Negative HTTPClient codes are local transport failures, not HTTP replies.
    exchange.error = "Cloud connection failed (" + String(code) + ": " + HTTPClient::errorToString(code) + ")";
    char detail[128] = {};
    const int tlsError = client.lastError(detail, sizeof(detail));
    if (tlsError) exchange.error += "; TLS " + String(tlsError) + ": " + detail;
  }
  else if (code != 200) exchange.error = "Cloud service returned HTTP " + String(code);
  else {
    DynamicJsonDocument inbound(2048);
    if (deserializeJson(inbound, request.getStream())) exchange.error = "Invalid cloud response";
    else serializeJson(inbound, exchange.response);
  }
  request.end();
  exchange.elapsed = millis() - started;
}
void cloudTransportTask(void*) {
  for (;;) {
    CloudExchange* exchange = nullptr;
    if (xQueueReceive(cloudRequests, &exchange, portMAX_DELAY) != pdTRUE) continue;
    performCloudExchange(*exchange);
    // HTTP/TLS resources have already been freed before handing ownership back.
    xQueueSend(cloudResponses, &exchange, portMAX_DELAY);
  }
}
bool configureCloudTransport() {
  cloudRequests = xQueueCreate(1, sizeof(CloudExchange*));
  cloudResponses = xQueueCreate(1, sizeof(CloudExchange*));
  if (cloudRequests && cloudResponses && xTaskCreatePinnedToCore(cloudTransportTask, "timiac-cloud", 10240, nullptr, 1, &cloudTask, 0) == pdPASS) return true;
  if (cloudRequests) vQueueDelete(cloudRequests);
  if (cloudResponses) vQueueDelete(cloudResponses);
  cloudRequests = cloudResponses = nullptr;
  return false;
}
