SDNT8810/Timiac/ESP_Timiac/src/cloudflare_certificate.h

#pragma once
// Public trust roots for Cloudflare HTTPS, from the Mozilla CA bundle.
// GTS R1/R4 and ISRG X1/X2 cover the supported Google/Let's Encrypt chains.
constexpr char kCloudflareRootCa[] = R"CERT(-----BEGIN CERTIFICATE-----
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
-----END CERTIFICATE-----
-----BEGIN CERTIFICATE-----
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
/q4AaOeMSQ+2b1tbFfLn
-----END CERTIFICATE-----
-----BEGIN CERTIFICATE-----
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
bP6MvPJwNQzcmRk13NfIRmPVNnGuV/u3gm3c
-----END CERTIFICATE-----
-----BEGIN CERTIFICATE-----
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
-----END CERTIFICATE-----
)CERT";
