SDNT8810/Timiac/tests/octopus_session_test.cpp

#ifdef NDEBUG
#error Tests require assertions
#endif
#include <cassert>
#include <iostream>
#include <string>
#include <vector>
#include "../shared/octopus_session.h"
using timiac::OctopusSession;
using State = OctopusSession::State;
uint32_t now = 4000;

void drivers(OctopusSession& s, int bad = -1, bool stealth = false, unsigned microsteps = timiac::driverMicrosteps, unsigned current = timiac::driverCurrent) {
  s.receive("\t\tX\tY\tZ\tI\tJ\tK", now);
  std::string currents = "Set current";
  for (unsigned a = 0; a < 6; ++a) currents += "\t" + std::to_string(current);
  s.receive(currents.c_str(), now);
  std::string steps = "msteps\t";
  for (unsigned a = 0; a < 6; ++a) steps += "\t" + std::to_string(microsteps);
  s.receive(steps.c_str(), now);
  s.receive(stealth ? "stealthChop\ttrue\ttrue\tfalse\tfalse\tfalse\tfalse" : "stealthChop\ttrue\ttrue\ttrue\ttrue\ttrue\ttrue", now);
  for (unsigned a = 0; a < 6; ++a) {
    std::string line = "Testing "; line += timiac::DriverReport::labels()[a];
    line += int(a) == bad ? " connection... Error: All HIGH" : " connection... OK";
    s.receive(line.c_str(), now);
  }
}
void identify(OctopusSession& s) {
  const std::string line = std::string("FIRMWARE_NAME:Marlin 2.1.2.7 MACHINE_TYPE:") + timiac::machineId + " EXTRUDER_COUNT:0 AXIS_COUNT:6";
  s.receive(line.c_str(), now); s.receive("ok", now);
}
void boot(OctopusSession& s, int bad = -1) {
  assert(std::string(s.next(now)) == "M115"); identify(s);
  assert(std::string(s.next(now)) == "M122"); drivers(s, bad); s.receive("ok", now);
  assert(s.state == State::Ready);
}
std::string drainMarker(const char* command) {
  assert(command);
  const char* marker = strstr(command, "M118 ");
  assert(marker); return marker + 5;
}
void drain(OctopusSession& s) {
  const std::string marker = drainMarker(s.stop(now));
  s.receive(marker.c_str(), now);
  assert(s.state == State::Drain); // The marker's own ok must also be consumed.
  s.receive("ok", now);
  assert(s.state == State::Offline);
}
std::vector<std::string> execute(OctopusSession& s, const char* line) {
  assert(s.stage(&line, 1, now));
  const char* prep = s.next(++now);
  if (prep) { assert(std::string(prep) == "M122"); drivers(s); s.receive("ok", now); s.next(++now); }
  assert(s.prepared()); assert(s.commit());
  std::vector<std::string> sent;
  for (unsigned i = 0; i < 50 && s.running(); ++i) {
    const char* command = s.next(++now);
    if (command) {
      sent.push_back(command);
      s.receive("ok", now);
    }
  }
  assert(!s.running()); return sent;
}
int main() {
  // Old low-current profiles or a thermally reduced current block new work.
  for (unsigned current : {250U, 600U, 800U, 1400U, 1414U, timiac::driverCurrent - 50}) {
    OctopusSession mismatch;
    mismatch.next(now); identify(mismatch); mismatch.next(now);
    drivers(mismatch, -1, false, timiac::driverMicrosteps, current); mismatch.receive("ok", now);
    assert(!mismatch.healthy(now) && mismatch.drivers.currentOk == 0);
    for (unsigned axis = 0; axis < 6; ++axis) {
      assert(mismatch.drivers.currentMa[axis] == int32_t(current));
      assert(mismatch.drivers.microsteps[axis] == 64);
    }
    const char* home = "G28 X";
    assert(!mismatch.stage(&home, 1, now));
  }
  // Thermal warnings and thermal current reduction have a specific fault;
  // cooling alone cannot silently resume a cancelled job.
  for (bool reduced : {false, true}) {
    OctopusSession hot; hot.next(now); identify(hot); hot.next(now);
    drivers(hot, -1, false, timiac::driverMicrosteps, reduced ? 950 : 1000);
    hot.receive(reduced ? " OTP\tfalse\tfalse\ttrue\tfalse\tfalse\tfalse"
                        : "OT prewarn\tfalse\tfalse\ttrue\tfalse\tfalse\tfalse", now);
    hot.receive("ok", now);
    assert(!hot.healthy(now) && strstr(hot.fault, "overheated/current reduced"));
    const char* move = "G1 Z1 F120"; assert(!hot.stage(&move, 1, now));
    hot.receive("start", now); now += 1001; boot(hot);
    assert(hot.healthy(now) && !hot.homed);
  }
  assert(timiac::validTrajectory("M204 T20.000", 6, 50, 500));
  assert(timiac::validTrajectory("M204 T25.000", 6, 50, 500));
  for (const char* invalid : {"M204 T95", "M204 T2e1", "M204 T-20", "M204 T20 S80", "G1 X1 F900"})
    assert(!timiac::validTrajectory(invalid, 6, 50, 500));
  // Neither native commands nor an old sensorless identity may enable motion.
  OctopusSession switches; boot(switches);
  for (const char* command : {"M914 X128", "M914 A128", "M23 test.gco", "M24", "M32 test.gco", "M98 Ptest.gco"}) {
    assert(!timiac::validNative(command, 6, 48, 700));
    assert(!switches.stage(&command, 1, now));
  }
  for (const char* suffix : {"-SG", "-old"}) {
    OctopusSession old; old.next(now);
    const std::string identity = std::string("FIRMWARE_NAME:Marlin MACHINE_TYPE:") + timiac::machineId + suffix + " AXIS_COUNT:6";
    old.receive(identity.c_str(), now); old.receive("ok", now);
    assert(!old.identity && !old.healthy(now) && old.fault[0]);
  }
  OctopusSession s; boot(s); assert(s.healthy(now));
  for (unsigned a = 0; a < 6; ++a) {
    std::string command = "G28 "; command += timiac::axes[a];
    auto sent = execute(s, command.c_str());
    assert((sent == std::vector<std::string>{"G21", "G90", "M220 S100", "M84 S0", "M204 T25.000", command, "M400", "M114"}));
    assert(s.homed == (1U << (a + 1)) - 1);
  }
  auto sent = execute(s, "G28 X Y Z A B C");
  assert((sent == std::vector<std::string>{"G21", "G90", "M220 S100", "M84 S0", "M204 T25.000", "G28 X Y Z A B C", "M400", "M114"}));
  assert(s.homed == 63);
  // The S0 setup keeps a homed pose trusted; explicit motor release still
  // clears all positions and requires a new Home before the next movement.
  for (const char* release : {"M18", "M84"}) {
    OctopusSession held; boot(held); held.homed = 63;
    for (bool& known : held.known) known = true;
    execute(held, "M114"); assert(held.homed == 63);
    execute(held, release); assert(!held.homed);
    for (bool known : held.known) assert(!known);
    const char* move = "G1 X1 F120"; assert(!held.stage(&move, 1, now));
  }
  for (unsigned percent : {20U, 50U, 100U}) {
    OctopusSession dance; boot(dance); dance.homed = 63;
    const char* frames[] = {"G1 X1 F500", "G4 P1000", "G1 X2 F250"};
    assert(dance.stage(frames, 3, now, true, percent));
    dance.next(++now); assert(dance.commit());
    std::vector<std::string> actual;
    while (dance.running()) if (const char* line = dance.next(++now)) {
      actual.push_back(line); dance.receive("ok", now);
    }
    const std::vector<std::string> expected = {"G21", "G90", "M220 S" + std::to_string(percent), "M84 S0", "M204 T25.000",
      frames[0], "G4 P" + std::to_string(100000U / percent), frames[2], "M400", "M114"};
    assert(actual == expected);
  }
  for (unsigned percent : {20U, 50U, 100U}) {
    OctopusSession slow; boot(slow);
    const char* homeAll = "G28 X Y Z A B C";
    assert(!slow.stage(&homeAll, 1, now, false, 0));
    assert(!slow.stage(&homeAll, 1, now, false, 19));
    assert(!slow.stage(&homeAll, 1, now, false, 101));
    assert(slow.stage(&homeAll, 1, now, false, percent));
    slow.next(now); drivers(slow); slow.receive("ok", now); slow.next(now); assert(slow.commit());
    for (const auto& expected : {std::string("G21"), std::string("G90"), "M220 S" + std::to_string(percent), std::string("M84 S0"), std::string("M204 T25.000")}) {
      assert(std::string(slow.next(now)) == expected); slow.receive("ok", now);
    }
    assert(std::string(slow.next(now)) == homeAll);
    const uint32_t limit = timiac::acknowledgementTimeout(homeAll, percent);
    assert(limit == 18000000U / percent);
    assert(!slow.next(now + limit - 1) && slow.running() && slow.online(now + limit - 1));
    assert(!slow.next(now + limit) && !slow.running());
    assert(std::string(slow.stop(now + limit)) == "M112");
  }
  // Continuous trajectories are bounded and still ack each line, but drain
  // the planner only once at the end (no M400/M114 between animation frames).
  const char* trajectory[timiac::maxTrajectoryCommands + 1];
  for (auto& line : trajectory) line = "G1 X1 F120";
  OctopusSession stream; boot(stream); stream.homed = 63;
  assert(!stream.stage(trajectory, 7, now)); // Ordinary requests retain their limit.
  assert(!stream.stage(trajectory, timiac::maxTrajectoryCommands + 1, now, true));
  stream.homed = 31; assert(!stream.stage(trajectory, 1, now, true)); stream.homed = 63;
  for (const char* invalid : {"G28 X", "M18", "G90", "M400", "G1 X53 F120"})
    assert(!stream.stage(&invalid, 1, now, true));
  assert(stream.stage(trajectory, timiac::maxTrajectoryCommands, now, true));
  stream.next(++now); assert(stream.prepared() && stream.commit());
  unsigned moves = 0, drains = 0, positions = 0;
  while (stream.running()) if (const char* line = stream.next(++now)) {
    assert(!stream.next(now)); // Cannot send the next command before this ack.
    if (!strncmp(line, "G1 ", 3)) { ++moves; assert(!drains && !positions); }
    if (!strcmp(line, "M400")) { ++drains; assert(moves == timiac::maxTrajectoryCommands); }
    if (!strcmp(line, "M114")) { ++positions; assert(drains == 1); }
    stream.receive("ok", now);
  }
  assert(moves == timiac::maxTrajectoryCommands && drains == 1 && positions == 1 && stream.completions == 1);
  // Stop or a UART error while queued cancels every remaining trajectory line.
  for (bool fault : {false, true}) {
    OctopusSession cancelled; boot(cancelled); cancelled.homed = 63;
    assert(cancelled.stage(trajectory, timiac::maxTrajectoryCommands, now, true));
    cancelled.next(++now); assert(cancelled.commit());
    for (unsigned n = 0; n < 3; ++n) { assert(cancelled.next(++now)); cancelled.receive("ok", now); }
    if (fault) cancelled.receive("Error:motion failed", now);
    const std::string marker = drainMarker(cancelled.stop(now));
    cancelled.receive("ok", now); assert(cancelled.state == State::Drain);
    cancelled.receive(marker.c_str(), now); cancelled.receive("ok", now);
    now += 1001; boot(cancelled);
    assert(!cancelled.running() && !cancelled.homed && !cancelled.completions);
    assert(!cancelled.next(now));
  }
  // A group does not become homed until its single acknowledgement arrives.
  OctopusSession grouped; boot(grouped);
  const char* group = "G28 X Y Z A B C";
  assert(grouped.stage(&group, 1, now)); grouped.next(now);
  drivers(grouped); grouped.receive("ok", now); grouped.next(now); assert(grouped.commit());
  grouped.next(now); grouped.receive("ok", now); // G21
  grouped.next(now); grouped.receive("ok", now); // G90
  grouped.next(now); grouped.receive("ok", now); // M220
  grouped.next(now); grouped.receive("ok", now); // M84 S0
  grouped.next(now); grouped.receive("ok", now); // restore M204
  assert(std::string(grouped.next(now)) == group && grouped.homed == 0);
  grouped.receive("Six-arm homing cancelled.", now); grouped.receive("ok", now);
  assert(grouped.homed == 0 && !grouped.healthy(now));
  execute(s, "G1 X1 Y2 Z3 A4 B5 C6 F120");
  execute(s, "G1 X2 F500");
  const char* tooFast = "G1 X3 F500.1";
  assert(!s.stage(&tooFast, 1, now));
  timiac::GcodeState fastParser; timiac::Step fastStep;
  assert(!timiac::compileLine("G90 X1 2 F500", fastParser, fastStep, 6, 48, timiac::maxFeed));
  assert(timiac::compileLine("G90 X1 3 F500.1", fastParser, fastStep, 6, 48, timiac::maxFeed));
  // Route all twelve PUBLIC addresses through the actual parser and kernel.
  for (unsigned board = 0; board < 2; ++board) {
    OctopusSession local; boot(local);
    for (unsigned axis = 0; axis < 6; ++axis) {
      char input[20]; snprintf(input, sizeof(input), "G28 %c%u", timiac::axes[axis], board + 1);
      timiac::Step step; timiac::GcodeState parser;
      assert(!timiac::compileLine(input, parser, step, 6, 48, 700));
      assert(step.count[board] == 1 && step.count[1 - board] == 0);
      auto commands = execute(local, step.lines[board][0]);
      assert(commands[5] == std::string("G28 ") + timiac::axes[axis]);
    }
  }
  // Preparing checks publish atomically; idle switches never interrupt a job.
  const char* allHome = "G28 X Y Z A B C";
  assert(s.stage(&allHome, 1, now));
  assert(std::string(s.next(now)) == "M122");
  assert(s.drivers.good() && !s.prepared());
  drivers(s); s.receive("ok", now); s.next(now); assert(s.prepared());
  assert(!s.next(now + 501)); // Still waiting for both-board commit.
  drain(s); now += 1001; boot(s);
  // A bare ok or old firmware must never authorize movement.
  OctopusSession old; old.next(now); old.receive("ok", now); assert(!old.healthy(now));
  assert(strstr(old.fault, "Wrong Octopus"));
  now += 1001; old.next(now); old.receive("FIRMWARE_NAME:Marlin AXIS_COUNT:6", now); old.receive("ok", now);
  assert(!old.healthy(now));
  // The exact X/Y-vs-Z/A/B/C mode mismatch is rejected before any G28.
  OctopusSession mode; mode.next(now); identify(mode); mode.next(now); drivers(mode, -1, true); mode.receive("ok", now);
  assert(!mode.healthy(now) && mode.drivers.modeOk == 3);
  const char* home = "G28 A"; assert(!mode.stage(&home, 1, now));
  // Every retired resolution must block motion with the new calibration.
  for (unsigned microsteps : {4U, 32U, 256U}) {
    OctopusSession wrongSteps; wrongSteps.next(now); identify(wrongSteps); wrongSteps.next(now);
    drivers(wrongSteps, -1, false, microsteps); wrongSteps.receive("ok", now);
    assert(!wrongSteps.healthy(now) && wrongSteps.drivers.stepsOk == 0);
    assert(!wrongSteps.stage(&home, 1, now));
  }
  // A truncated or reordered report cannot borrow values from the last report.
  OctopusSession partial; boot(partial); assert(partial.stage(&home, 1, now));
  partial.next(now); partial.receive("ok", now);
  assert(!partial.healthy(now) && !partial.prepared());
  for (int a = 0; a < 6; ++a) {
    OctopusSession broken; boot(broken, a);
    assert(!broken.healthy(now)); assert(broken.drivers.connected == (63U & ~(1U << a)));
    assert(!broken.stage(&home, 1, now));
  }
  // After an individual home the kernel allows only that axis' move.
  OctopusSession one; boot(one); execute(one, "G28 A");
  execute(one, "G1 A1 F120");
  const char* badMove = "G1 B1 F120"; assert(!one.stage(&badMove, 1, now));
  // Stop really reaches Marlin and drains late acknowledgements before reconnecting.
  const char* move = "G1 A2 F120"; assert(one.stage(&move, 1, now)); one.next(now); assert(one.commit());
  const char* stopping = one.stop(now); assert(strstr(stopping, "M410"));
  const std::string stoppedMarker = drainMarker(stopping);
  one.receive("ok", now); assert(one.state == State::Drain && !one.healthy(now));
  one.receive(stoppedMarker.c_str(), now); assert(one.state == State::Drain);
  one.receive("ok", now); assert(one.state == State::Offline);
  now += 1001; boot(one); assert(one.healthy(now) && one.homed == 0);
  // Reproduce the screenshot: an idle timeout and missing Stop reply must not
  // invent a Marlin halt. Recover only after the latest drain marker AND ok.
  OctopusSession disconnected; boot(disconnected); execute(disconnected, "G28 Z");
  disconnected.monitor = true; now += 501;
  assert(std::string(disconnected.next(now)) == "M119");
  now += 10001;
  const char* probe = disconnected.next(now);
  assert(probe && strstr(probe, "M118") && !strstr(probe, "M410"));
  assert(disconnected.homed == 4 && !disconnected.failures && !disconnected.healthy(now));
  now += 10000; assert(!disconnected.next(now));
  assert(strstr(disconnected.fault, "diagnostic recovery timed out") && disconnected.failures == 1);
  std::string previous = drainMarker(disconnected.stop(now));
  for (unsigned retry = 0; retry < 3; ++retry) {
    assert(!disconnected.next(now + 9999));
    now += 10000;
    std::string current = drainMarker(disconnected.next(now));
    assert(current != previous && !disconnected.halted() && !disconnected.healthy(now));
    assert(disconnected.state == State::Drain && disconnected.failures == 1);
    disconnected.receive(previous.c_str(), now); disconnected.receive("ok", now);
    assert(disconnected.state == State::Drain); // A superseded attempt cannot authorize a handshake.
    assert(!disconnected.stage(&home, 1, now));
    previous = current;
  }
  disconnected.receive(("echo:" + previous).c_str(), now);
  assert(disconnected.state == State::Drain && !disconnected.next(now));
  disconnected.receive("ok", now); assert(disconnected.state == State::Offline);
  now += 1001; boot(disconnected);
  assert(disconnected.healthy(now) && !disconnected.homed && disconnected.completions == 1);
  assert(!disconnected.next(now)); // Cancelled motion is never replayed.
  // A timeout is still a new failure when an earlier driver fault is retained.
  OctopusSession faulty; boot(faulty, 2); now += 5001;
  assert(std::string(faulty.next(now)) == "M122");
  now += 10001; faulty.next(now);
  assert(faulty.failures == 1 && strstr(faulty.fault, "Driver check failed"));
  drain(faulty); now += 1001; boot(faulty);
  assert(faulty.healthy(now));
  // A homing stop is a real emergency; no automatic firmware-reset or motion retry.
  s.receive("start", now); now += 1001; boot(s);
  assert(s.stage(&home, 1, now)); s.next(now); drivers(s); s.receive("ok", now); s.next(now); assert(s.commit());
  s.next(now); s.receive("ok", now); s.next(now); s.receive("ok", now);
  s.next(now); s.receive("ok", now); // M220
  s.next(now); s.receive("ok", now); // M84 S0
  s.next(now); s.receive("ok", now); // M204 normal acceleration
  assert(std::string(s.next(now)) == "G28 A");
  assert(std::string(s.stop(now)) == "M112"); assert(s.halted() && s.homed == 0);
  s.receive("ok", now); s.receive("Error:Printer halted. kill() called!", now);
  assert(s.halted() && s.next(now + 200000) == nullptr);
  s.fail("Octopus serial receive overrun");
  assert(s.halted()); // A later communication error cannot unlock a killed board.
  s.receive("start", now); now += 1001; boot(s); assert(s.healthy(now) && !s.homed);
  // Preserve the first fault, including the exact failed axis, across Stop.
  OctopusSession badSwitch; boot(badSwitch);
  badSwitch.receive("echo:Bad A Endstop?", now);
  badSwitch.receive("Error:Printer halted. kill() called!", now); badSwitch.stop(now);
  assert(std::string(badSwitch.fault) == "echo:Bad A Endstop?" && badSwitch.halted());
  OctopusSession groupSwitch; boot(groupSwitch);
  const char* groupFault = "Error:Six-arm homing: endstop did not release [axes: A C]";
  groupSwitch.receive(groupFault, now);
  groupSwitch.receive("Error:Printer halted. kill() called!", now); groupSwitch.stop(now);
  assert(std::string(groupSwitch.fault) == groupFault && groupSwitch.halted());
  // Homing can run past the old 60/120-second deadlines. Timeout still stops it.
  assert(s.stage(&home, 1, now)); s.next(now); drivers(s); s.receive("ok", now); s.next(now); s.commit();
  s.next(now); s.receive("ok", now); s.next(now); s.receive("ok", now); s.next(now);
  s.receive("ok", now); s.next(now); // M220 ack, then M84 S0
  s.receive("ok", now); s.next(now); // M84 S0 ack, then M204
  s.receive("ok", now); s.next(now); // M204 ack, then G28
  assert(s.next(now + 120001) == nullptr && s.running());
  assert(s.next(now + 180001) == nullptr && !s.running());
  assert(std::string(s.stop(now + 180001)) == "M112");
  // Diagnostics are atomic, and can run even if a driver's communication fails.
  OctopusSession lamps; boot(lamps, 2); lamps.monitor = true; now += 501;
  assert(std::string(lamps.next(now)) == "M119");
  for (const char* line : {"x_min: open", "y_min: open", "z_min: TRIGGERED", "a_min: open", "b_min: open", "c_min: open"}) lamps.receive(line, now);
  assert(!lamps.endstops.known); lamps.receive("ok", now);
  assert(lamps.endstops.known == 63 && lamps.endstops.triggered == 4);
  // Passing drivers are rechecked automatically, without a motion job or the
  // other board. A completed replacement report immediately changes the result.
  OctopusSession live; boot(live); live.monitor = true;
  assert(live.driverReportAvailable && live.driverReportAge(now) == 0);
  now += 2001; assert(std::string(live.next(now)) == "M122");
  drivers(live, 2);
  assert(live.drivers.good()); // A partial report cannot overwrite completed checks.
  live.receive("ok", now);
  assert(!live.healthy(now) && live.drivers.connected == 59 && live.driverReportAge(now) == 0);
  now += 2001; assert(std::string(live.next(now)) == "M122");
  drivers(live); live.receive("ok", now);
  assert(live.healthy(now) && live.drivers.connected == 63 && !live.homed);
  now += 1200; assert(live.driverReportAge(now) == 1200);
  live.receive("start", now);
  assert(!live.driverReportAvailable && !live.drivers.tested);
  // A lost read-only report fences late ok replies and re-identifies the
  // Octopus without throwing away calibrated positions or replaying movement.
  OctopusSession soak; boot(soak); soak.homed = 63;
  for (unsigned a = 0; a < 6; ++a) { soak.known[a] = true; soak.positions[a] = a + 10; }
  unsigned interruptions = 0;
  for (unsigned poll = 0; poll < 34560; ++poll) { // 48 hours at one diagnostic every five seconds.
    now += 5001; assert(std::string(soak.next(now)) == "M122");
    if (poll % 97 == 0) {
      if (poll % 2) {
        now += 10001;
        const char* command = soak.next(now);
        assert(command && !strncmp(command, "M118 ", 5));
      } else {
        soak.receive("\t\tX\tY\tZ\tI\tJ\tK", now); soak.receive("ok", now);
        assert(soak.next(now) && soak.state == State::Drain);
      }
      const std::string marker = drainMarker(soak.active);
      assert(!soak.healthy(now) && soak.homed == 63 && !soak.failures);
      soak.receive("ok", now); assert(soak.state == State::Drain);
      soak.receive(marker.c_str(), now); assert(soak.state == State::Drain);
      soak.receive("ok", now); now += 1001;
      assert(std::string(soak.next(now)) == "M115"); identify(soak);
      assert(!soak.healthy(now) && !soak.drivers.good() && soak.homed == 63);
      assert(std::string(soak.next(now)) == "M122"); drivers(soak); soak.receive("ok", now);
      assert(soak.state == State::Ready); ++interruptions;
    } else { drivers(soak); soak.receive("ok", now); }
    assert(soak.healthy(now) && soak.homed == 63 && !soak.failures && !soak.completions);
    for (unsigned a = 0; a < 6; ++a) assert(soak.known[a] && soak.positions[a] == a + 10);
  }
  assert(soak.diagnosticRecoveries == interruptions);
  // Actual thermal/driver failures, moving timeouts and board restarts retain
  // their existing interlocks; retries are restricted to idle read-only work.
  now += 5001; assert(std::string(soak.next(now)) == "M122");
  drivers(soak); soak.receive("OT prewarn\ttrue\tfalse\tfalse\tfalse\tfalse\tfalse", now); soak.receive("ok", now);
  assert(!soak.healthy(now) && soak.drivers.thermalWarning == 1 && soak.state == State::Ready);
  assert(!soak.retryDiagnostic(now));
  soak.receive("start", now); assert(!soak.homed);
  std::cout << "Idle diagnostics: 48 simulated hours with " << interruptions << " fenced interruptions; positions preserved and real thermal faults still blocked\n";
  std::cout << "Octopus kernel: identity, driver modes, all six axes, stop, recovery, homing timeout and switches passed\n";
}
