SDNT8810/Timiac/tools/generate_presets.py

"""Generate embedded animation frames and hardware examples from simulator G-code."""
from pathlib import Path
import re
import json

ROOT = Path(__file__).resolve().parents[1]
SIM_AXES = "ABCDEHIJKLUV"
# Simulator A..V runs clockwise from 12; physical XYZABC / XYZABC is reversed.
HW_AXES = ["X1", "C2", "B2", "A2", "Z2", "Y2", "X2", "C1", "B1", "A1", "Z1", "Y1"]
PRESETS = {"hour": "hour-movement", "curious": "curious-creature"}


def frames(source):
    result = []
    for number, raw in enumerate(source.splitlines(), 1):
        line = raw.split(";", 1)[0].strip()
        if not line or line == "G90":
            continue
        tokens = line.split()
        values, feed, dwell = [-1.0] * 12, 0.0, 0
        if tokens[0] == "G4" and len(tokens) == 2 and re.fullmatch(r"P\d+", tokens[1]):
            dwell = int(tokens[1][1:])
            if not 0 < dwell <= 120000:
                raise ValueError(f"Invalid dwell on line {number}")
        elif tokens[0] == "G1":
            for token in tokens[1:]:
                if not re.fullmatch(r"[ABCDEHIJKLUVF]\d+(?:\.\d+)?", token):
                    raise ValueError(f"Unsupported token {token} on line {number}")
                key, value = token[0], float(token[1:])
                if key == "F":
                    if feed or value <= 0:
                        raise ValueError(f"Invalid feed on line {number}")
                    feed = value
                else:
                    index = SIM_AXES.index(key)
                    if values[index] >= 0 or not 0 <= value <= 100:
                        raise ValueError(f"Invalid axis on line {number}")
                    values[index] = value
            if not feed or all(value < 0 for value in values):
                raise ValueError(f"Missing motion/feed on line {number}")
        else:
            raise ValueError(f"Unsupported command on line {number}: {line}")
        result.append((values, feed, dwell))
    if not result:
        raise ValueError("Empty preset")
    return result


def write_changed(path, text):
    if not path.exists() or path.read_text(encoding="utf-8") != text:
        path.write_text(text, encoding="utf-8")


def generate():
    machine = json.loads((ROOT / "machine.json").read_text())
    travel, max_feed = machine["travel_mm"], machine["max_feed_mm_min"]
    scale = travel / 100
    header = ["// Generated by tools/generate_presets.py; edit shared/struggle-patterns.json or Simulator/gcodes.", "#pragma once", "namespace timiac {",
              "struct PresetFrame { float positions[12]; float feed; unsigned dwell; };"]
    patterns = json.loads((ROOT / "shared/struggle-patterns.json").read_text(encoding="utf-8"))
    if len(patterns) != 7 or len({p["id"] for p in patterns}) != 7:
        raise ValueError("Exactly seven distinct Struggle patterns are required")
    simulator = []
    for index, pattern in enumerate(patterns):
        poses = []
        header.append(f"constexpr PresetFrame struggle{index}Frames[] = {{")
        for frame in pattern["frames"]:
            mm, feed = frame["openMm"], frame["feed"]
            if len(mm) != 12 or not all(0 <= value <= min(20, travel) for value in mm) or not 0 < feed <= 800:
                raise ValueError(f"Unsafe Struggle frame in {pattern['id']}")
            values = [value / scale for value in mm]
            poses.append({"positions": values, "feed": feed})
            header.append("  {{" + ", ".join(f"{v:g}" for v in values) + f"}}, {feed:g}, 0" + "},")
        # This placeholder is replaced with the selected clock pose at runtime.
        header.append("  {{100, 50, 0, 0, 0, 0, 0, 0, 0, 0, 0, 0}, 800, 0},")
        header.append("};")
        simulator.append({key: pattern[key] for key in ("id", "name", "note")} | {"frames": poses})
    header.append("struct StrugglePattern { const char* name; const PresetFrame* frames; unsigned count; };")
    header.append("constexpr StrugglePattern strugglePatterns[] = {")
    for index, pattern in enumerate(patterns):
        header.append(f"  {{{json.dumps(pattern['name'])}, struggle{index}Frames, sizeof(struggle{index}Frames) / sizeof(PresetFrame)}},")
    header += ["};", "constexpr unsigned struggleVariantCount = sizeof(strugglePatterns) / sizeof(StrugglePattern);"]
    write_changed(ROOT / "Simulator/src/struggle-patterns.generated.js",
                  "// Generated by tools/generate_presets.py from shared/struggle-patterns.json.\n"
                  + "export const STRUGGLE_PATTERNS = " + json.dumps(simulator, indent=2) + ";\n")
    # Keep the existing standalone example filename, now using Scramble.
    # Firmware and the interactive simulator select all seven patterns at runtime.
    example = ["; Struggle 1/7: Scramble. 0-20 mm openings, then 01:00.", "G90"]
    for pose in simulator[0]["frames"] + [{"positions": [100, 50] + [0] * 10, "feed": 800}]:
        example.append("G1 " + " ".join(f"{axis}{value:g}" for axis, value in zip(SIM_AXES, pose["positions"])) + f" F{pose['feed']:g}")
    write_changed(ROOT / "Simulator/gcodes/circular-struggle.gcode", "\n".join(example) + "\n")
    hardware = ["; Generated Scramble example; built-in Struggle selects from seven patterns.",
                "; Openings are 0-20 mm; the final time pose may open the time arms further.",
                "; Native coordinates: 0 mm = open/home, 50 mm = closed. Home first.", "G90"]
    for values, feed, dwell in frames("\n".join(example)):
        words = [f"{axis} {(100 - value) * scale:.3f}" for axis, value in zip(HW_AXES, values)]
        hardware.append("G1 " + " ".join(words) + f" F{min(max_feed, feed * scale):.3f}")
    write_changed(ROOT / "gcodes/circular-struggle.gcode", "\n".join(hardware) + "\n")
    for name, filename in PRESETS.items():
        data = frames((ROOT / f"Simulator/gcodes/{filename}.gcode").read_text(encoding="utf-8-sig"))
        if name == "hour":
            write_changed(ROOT / "Simulator/src/hour-pattern.generated.js",
                          "// Generated by tools/generate_presets.py from Simulator/gcodes/hour-movement.gcode.\n"
                          + "export const HOUR_FRAMES = " + json.dumps([
                              {"positions": positions, "feed": feed} for positions, feed, dwell in data
                          ], indent=2) + ";\n")
        header.append(f"constexpr PresetFrame {name}Frames[] = {{")
        example = [f"; Generated from Simulator/gcodes/{filename}.gcode", f"; Hardware: {travel:g} mm stroke, maximum {max_feed:g} mm/min. Home all axes first.",
                   "; Clockwise from 12: " + " ".join(HW_AXES),
                   f"; Inverted mechanism: 0 mm = fully open/home, {travel:g} mm = closed.", "G90"]
        for positions, feed, dwell in data:
            header.append("  {{" + ", ".join(f"{v:g}" for v in positions) + f"}}, {feed:g}, {dwell}" + "},")
            if dwell:
                example.append(f"G4 P{dwell}")
            else:
                words = [f"{axis} {(100 - value) * scale:.3f}" for axis, value in zip(HW_AXES, positions) if value >= 0]
                example.append("G1 " + " ".join(words) + f" F{min(max_feed, feed * scale):.3f}")
        header.append("};")
        write_changed(ROOT / f"gcodes/{filename}.gcode", "\n".join(example) + "\n")
    header.append("}")
    write_changed(ROOT / "shared/presets_generated.h", "\n".join(header) + "\n")


if __name__ == "__main__":
    generate()
