SDNT8810/Timiac/(commit log)

2026-10-06 increase power demand and reduce accelerations
2026-10-06 Make repository cloning reproducible and preserve local Marlin edits
2026-10-08 reduce struggle and next hour power consumption to prevent overheating
2026-10-15 Shorten Struggle to shared 30-10-30 mm poses ending at the current time
2026-10-15 Replace ultrasonic input with GPIO27 infrared sensor and master wiring diagram
2026-10-15 Add seven random insect Struggles with 20 mm openings and simulator previews
2026-10-15 Enable cloud updates for all five boards with staged Octopus flashing
2026-10-15 Finalize matched 75 percent motion package and doubled homing
2026-10-15 Preserve exact local Marlin edits in the archived patch
2026-10-15 Build and install every firmware from one Full update button
2026-10-16 Keep clock control independent of cloud stalls and recover idle diagnostics
2026-10-17 Recover stalled OTA updates and preserve reboot diagnostics
2026-10-19 Allow ESP32 cloud TLS negotiation more time and retain transport diagnostics
2026-10-19 Reduce holding current while retaining full movement torque
2026-10-19 Retry interrupted local updater reads and add a safe connection check
2026-10-19 Keep Octopus SD update commands within the installed UART receive buffer
2026-10-20 Fix cloud TLS memory and Wi-Fi recovery; clarify NPN sensor wiring
2026-10-20 Avoid rewriting the shallow boundary when fetching the pinned Marlin tag
2026-10-20 Read the installed hand sensor through ADC1 GPIO34
2026-10-20 Show cloud sensor status and retain gesture trigger diagnostics
2026-10-20 Label unavailable sensor history from older masters accurately
2026-10-20 Improve hand sensor response and allow stopped calibration
2026-10-20 Rearm hand gestures after 300 milliseconds clear
2026-10-22 Disable faulty hand sensor for manual Struggle control [skip ci]
2026-10-22 sensor on
2026-10-22 Restore hand sensor sampling on master [skip ci]
2026-10-22 Reject low-range sensor noise and require continuous hand debounce
