SDNT8810/Timiac/(notices)

Notices in the files:
Marlin/profiles/lumiac-reference/Configuration.h:
Copyright (c) 2022 MarlinFirmware [https://github.com/MarlinFirmware/Marlin]
Copyright (c) 2011 Camiel Gubbels / Erik van der Zalm
This program is free software: you can redistribute it and/or modify
it under the terms of the GNU General Public License as published by
the Free Software Foundation, either version 3 of the License, or
(at your option) any later version.
Marlin/profiles/lumiac-reference/Configuration_adv.h:
define TOUCH_UI_UTF8_COPYRIGHT // © ®
